allanschwartz/ClockWall/_Hardware/EliArbel-clockwall/415910_10150989229823438_1177839544_o.jpg

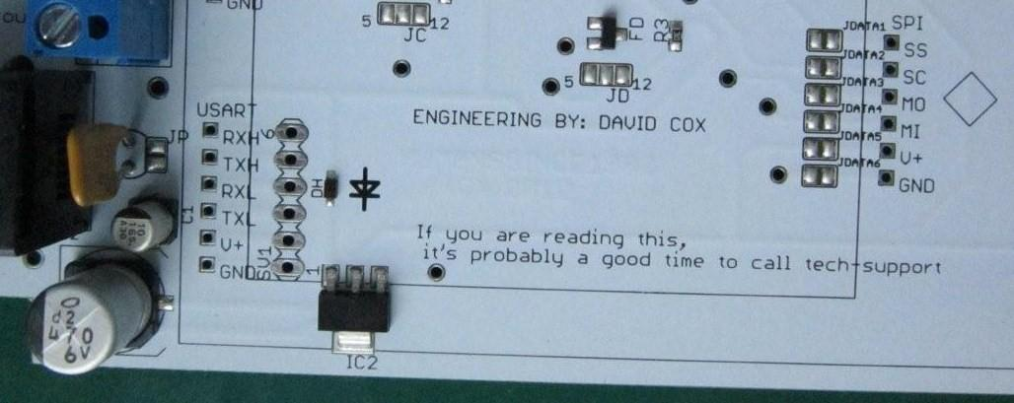
_Hardware/EliArbel-clockwall/415910_10150989229823438_1177839544_o.jpg
