allanschwartz/ClockWall/_Documentation/Connecting Arduinos paper/photos for paper/breadboard2.jpg

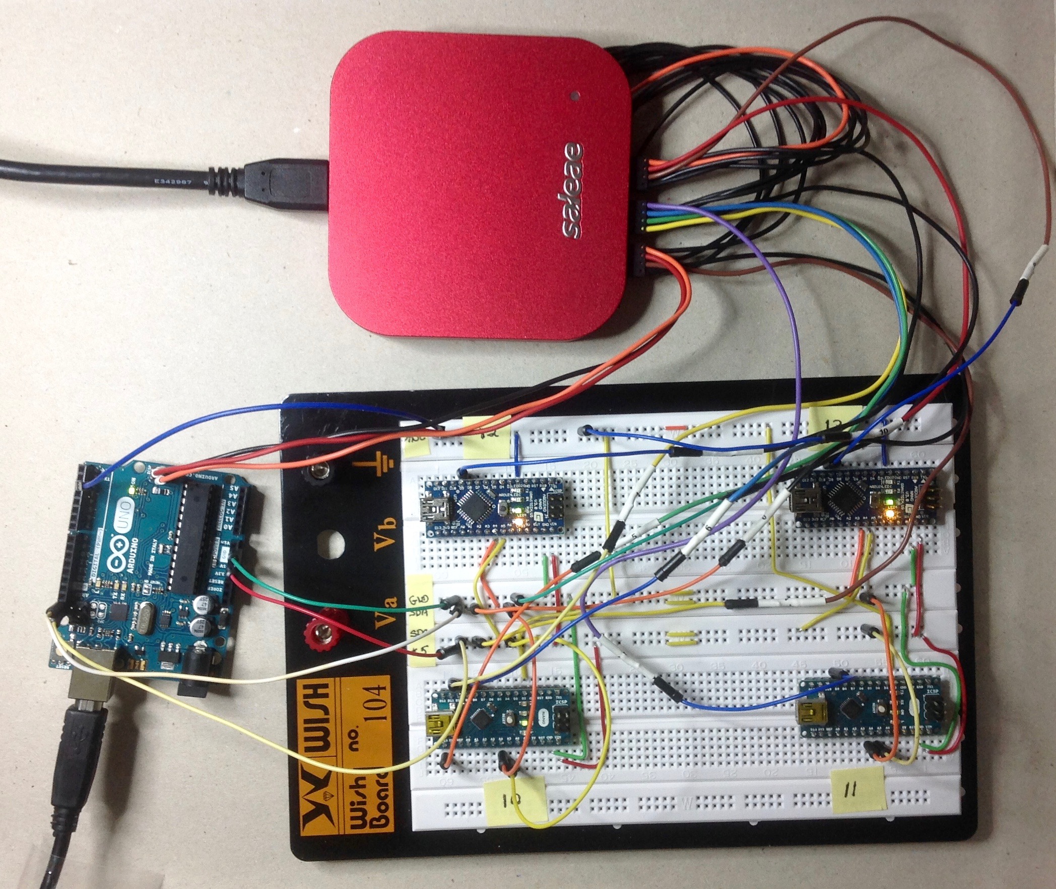
_Documentation/Connecting Arduinos paper/photos for paper/breadboard2.jpg
