allanschwartz/ClockWall/_Documentation/clockwall-arch.pptx

## Slide 2

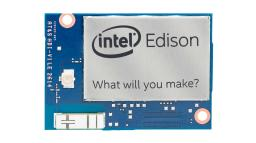
[picture p24: figure]
