allanschwartz/ClockWall/_Documentation/Connecting Arduinos paper/photos for paper/a-million-times_3-620x320.jpg

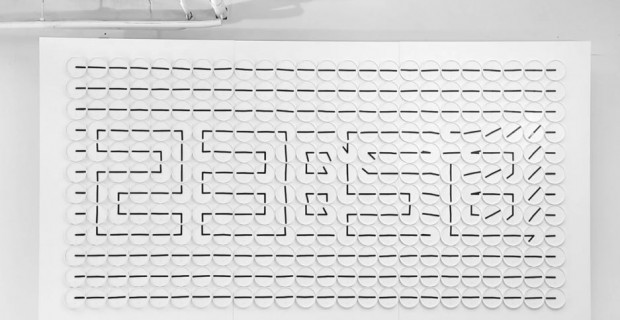
_Documentation/Connecting Arduinos paper/photos for paper/a-million-times_3-620x320.jpg
