allanschwartz/ClockWall/_Documentation/Connecting Arduinos paper/screenshots, connecting arduinos/exper all, 20s,.png

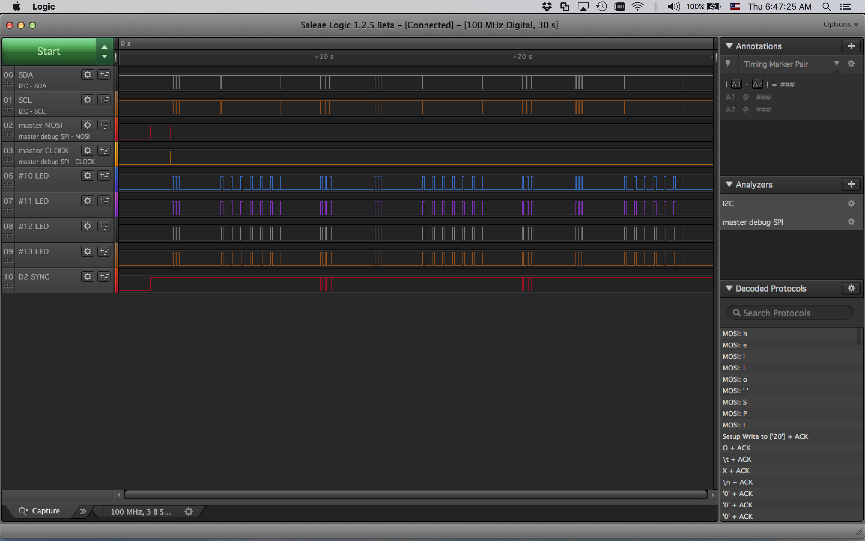
_Documentation/Connecting Arduinos paper/screenshots, connecting arduinos/exper all, 20s,.png
