allanschwartz/ClockWall/_Hardware/_VID28 Motor/Glorification-original-vid28-05-instrument-motor-jac-yuet-with-micro-stepper-motor.jpg

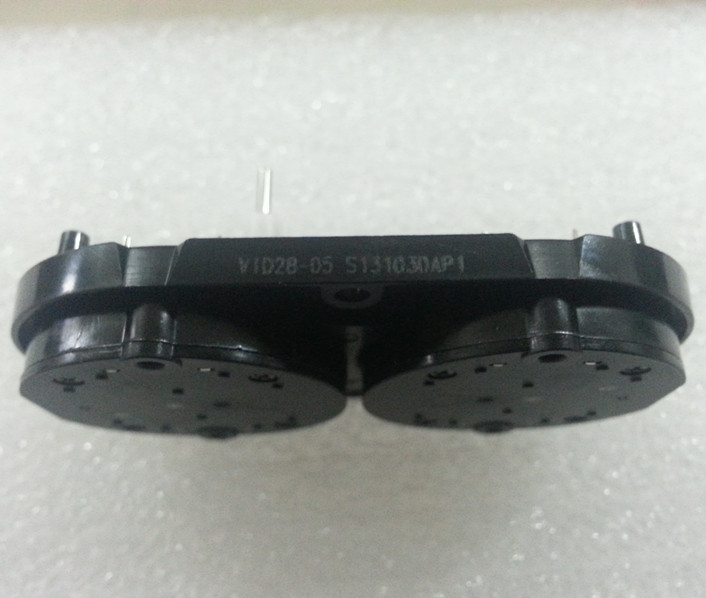
_Hardware/_VID28 Motor/Glorification-original-vid28-05-instrument-motor-jac-yuet-with-micro-stepper-motor.jpg
