allanschwartz/ClockWall/_Hardware/abandoned 4_clock_module/4_clocks, Mar 24, 2017.jpeg

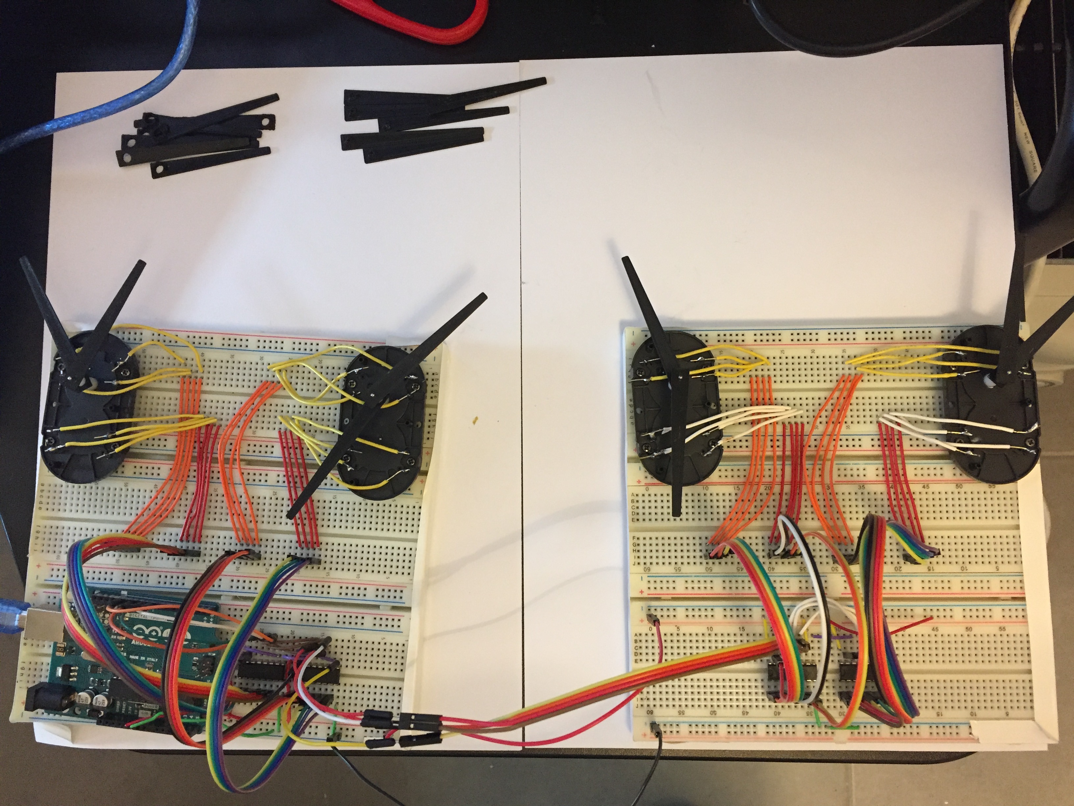
_Hardware/abandoned 4_clock_module/4_clocks, Mar 24, 2017.jpeg
