allanschwartz/ClockWall/_Hardware/bezels and clock-hands detail.png

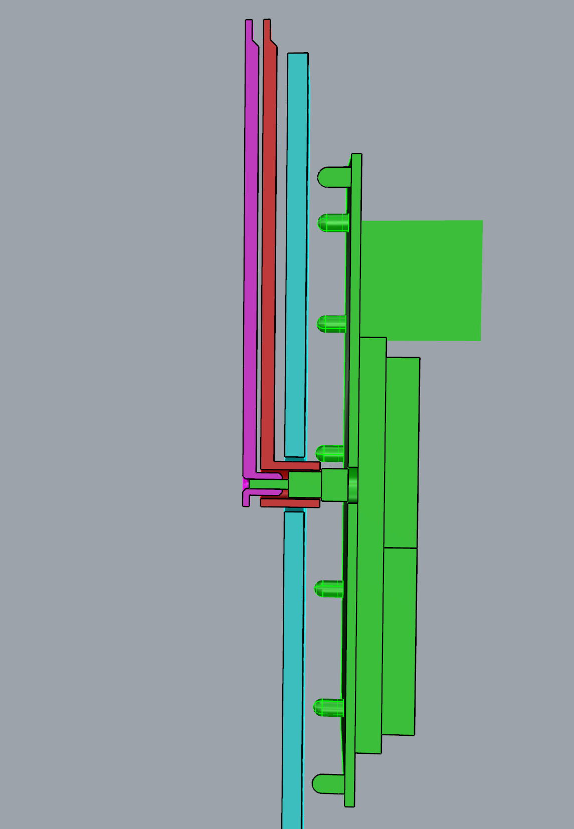
_Hardware/bezels and clock-hands detail.png
