allanschwartz/ClockWall/_Hardware/cables/clock module cable, 2.54mm, 2017-10-07.png

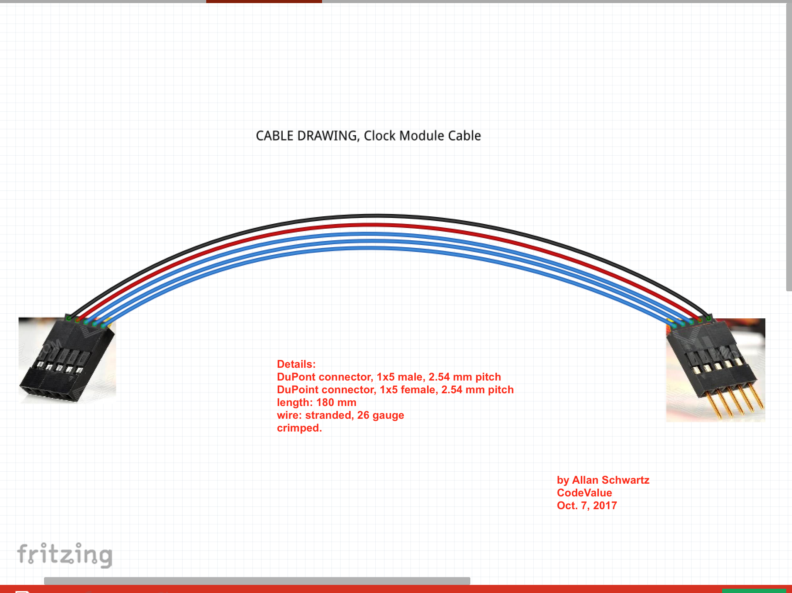
_Hardware/cables/clock module cable, 2.54mm, 2017-10-07.png
