allanschwartz/ClockWall/_Hardware/cables/Screen Shot 2017-12-07 at 11.31.00 AM.png

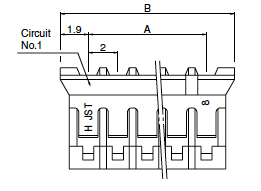
_Hardware/cables/Screen Shot 2017-12-07 at 11.31.00 AM.png
