allanschwartz/ClockWall/_Hardware/Driver-options/FE0HJ4IHD2RLNN4.LARGE.jpg

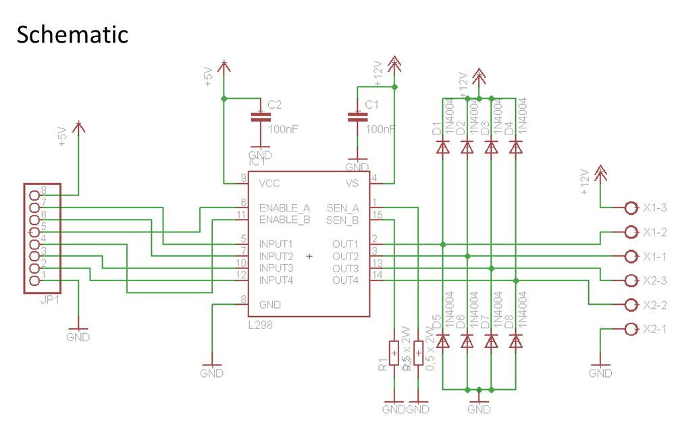
_Hardware/Driver-options/FE0HJ4IHD2RLNN4.LARGE.jpg
