allanschwartz/ClockWall/_Hardware/EliArbel-clockwall/1505503_10152708555028438_704475474_n.jpg

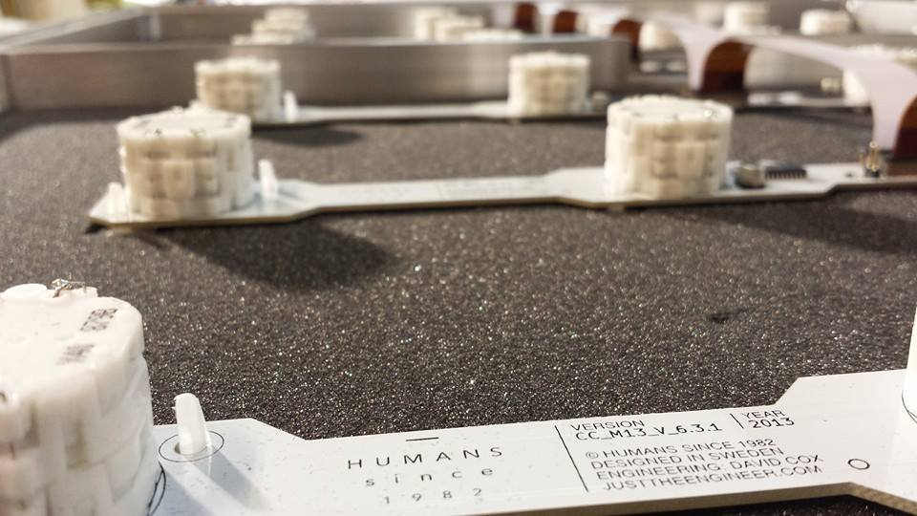
_Hardware/EliArbel-clockwall/1505503_10152708555028438_704475474_n.jpg
