allanschwartz/ClockWall/_Hardware/EliArbel-clockwall/amt96-1280x1280px9.jpg

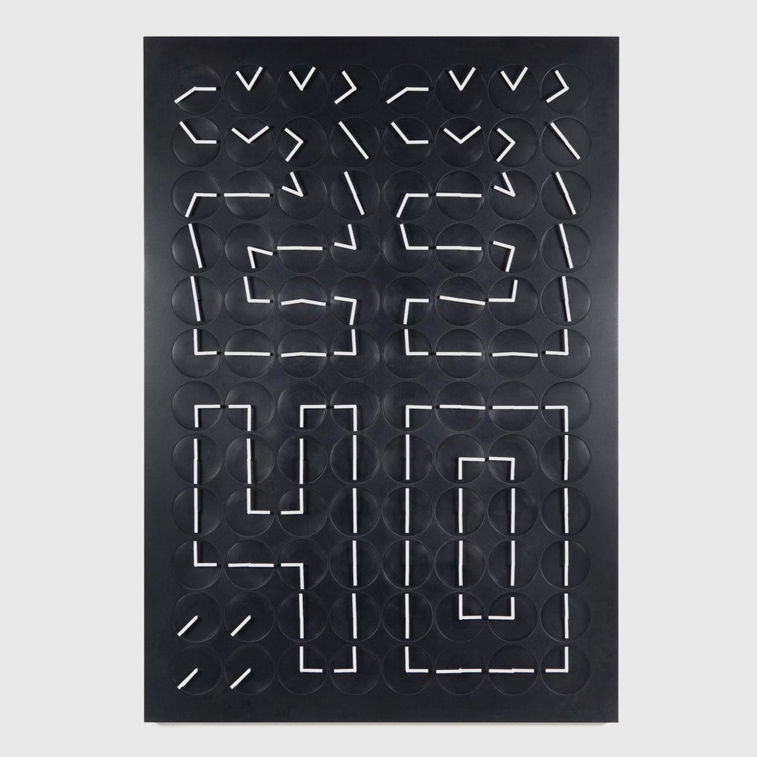
_Hardware/EliArbel-clockwall/amt96-1280x1280px9.jpg
