allanschwartz/ClockWall/_Hardware/EliArbel-clockwall/amt288-1280x1280px1.jpg

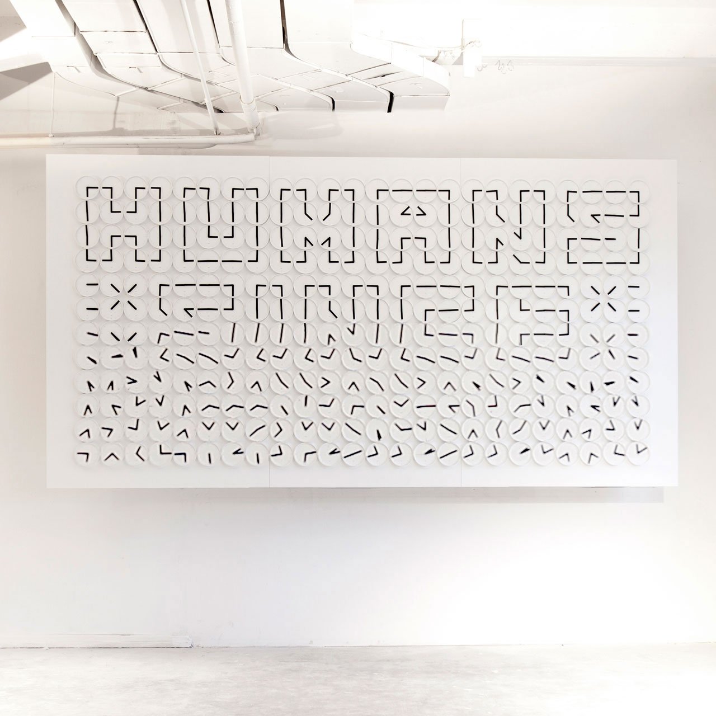
_Hardware/EliArbel-clockwall/amt288-1280x1280px1.jpg
