allanschwartz/ClockWall/_Hardware/EliArbel-clockwall/detail1.jpg

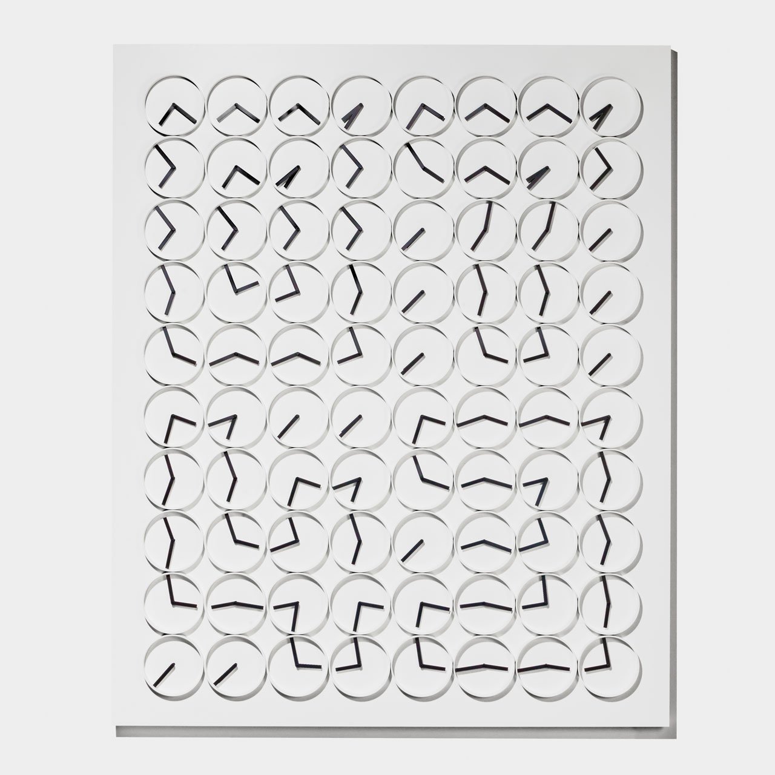
_Hardware/EliArbel-clockwall/detail1.jpg
