allanschwartz/ClockWall/_Hardware/EliArbel-clockwall/detail-1.jpg

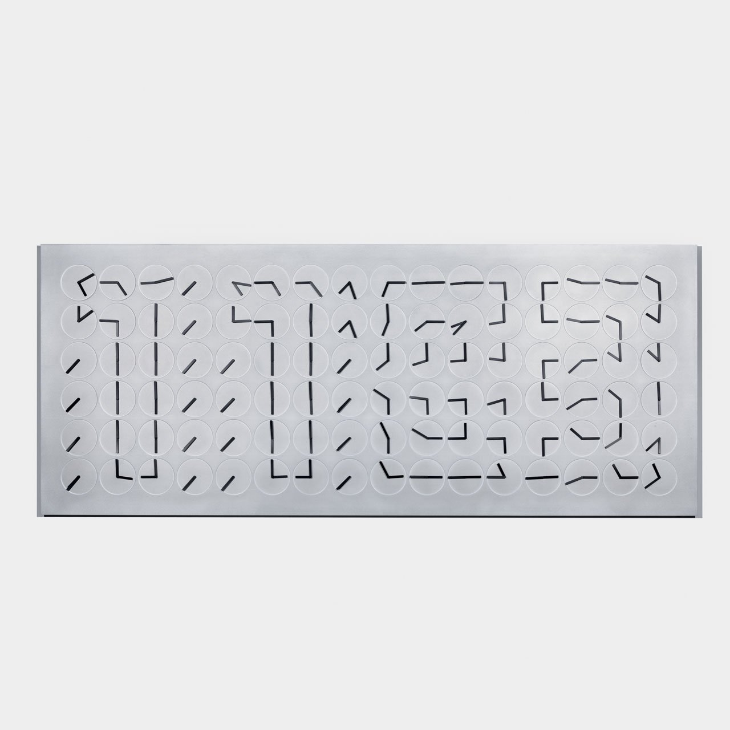
_Hardware/EliArbel-clockwall/detail-1.jpg
