allanschwartz/ClockWall/_Hardware/EliArbel-clockwall/hs1982-amt24-anodized-a-1280x1280px.jpg

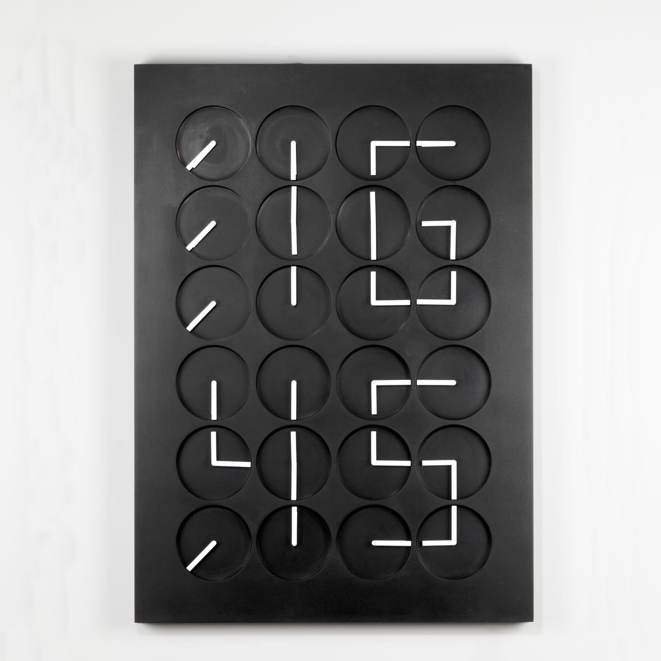
_Hardware/EliArbel-clockwall/hs1982-amt24-anodized-a-1280x1280px.jpg
