allanschwartz/ClockWall/_Hardware/EliArbel-clockwall/hs1982-amt84v-anodized-a-1280x1280px_0.jpg

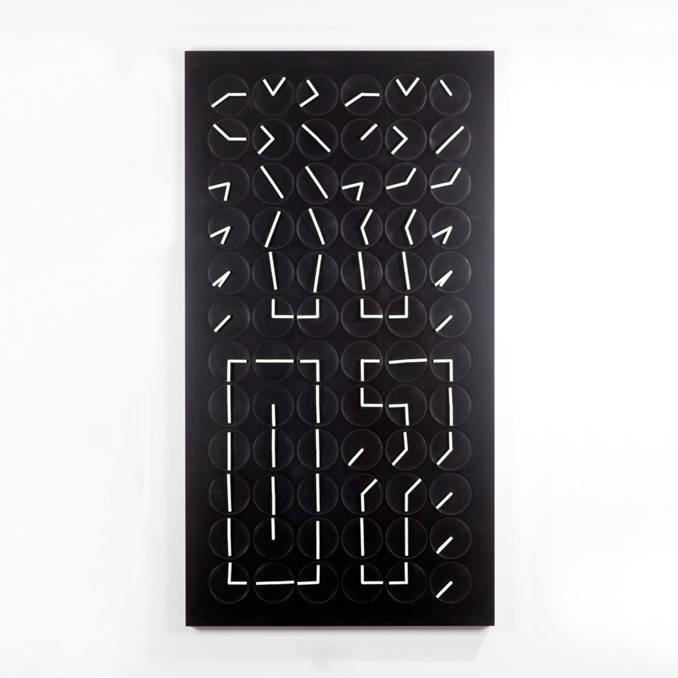
_Hardware/EliArbel-clockwall/hs1982-amt84v-anodized-a-1280x1280px_0.jpg
