allanschwartz/ClockWall/_Hardware/LDR work/IMG_3464.jpg

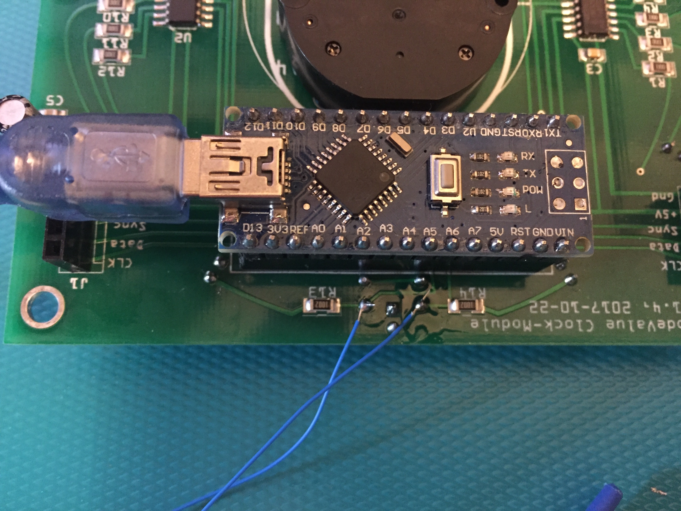
_Hardware/LDR work/IMG_3464.jpg
