allanschwartz/ClockWall/_Hardware/LDR work/IMG_3467.jpg

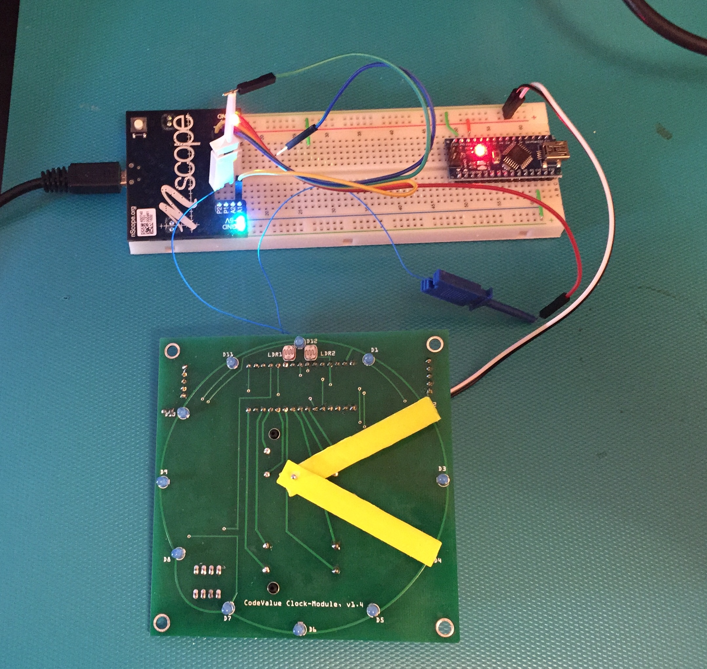
_Hardware/LDR work/IMG_3467.jpg
