allanschwartz/ClockWall/_Hardware/LDR work/LDR capture 1.png

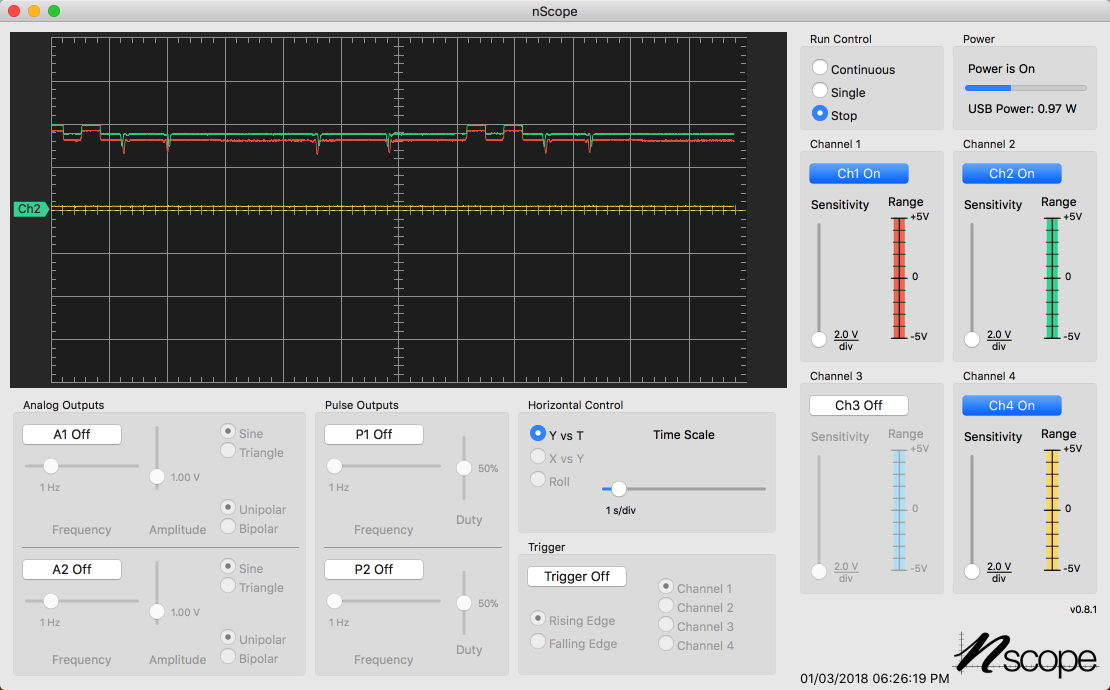
_Hardware/LDR work/LDR capture 1.png
