allanschwartz/ClockWall/_Hardware/neopixel ring 12.png

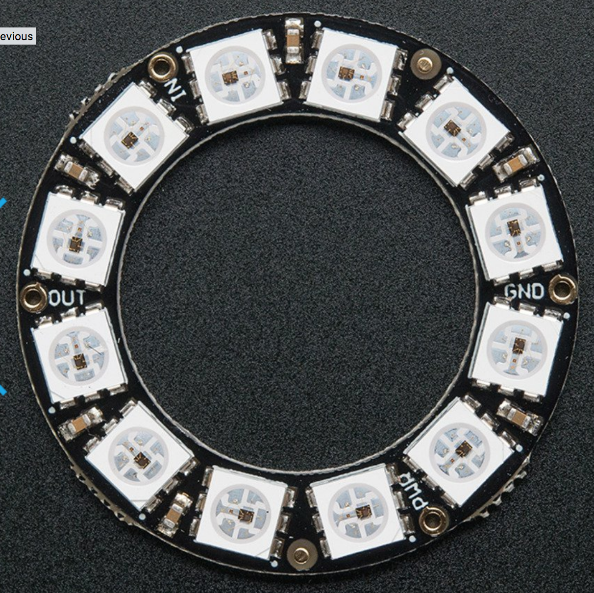
_Hardware/neopixel ring 12.png
