allanschwartz/ClockWall/_Hardware/neopixel ring 2851-01.jpg

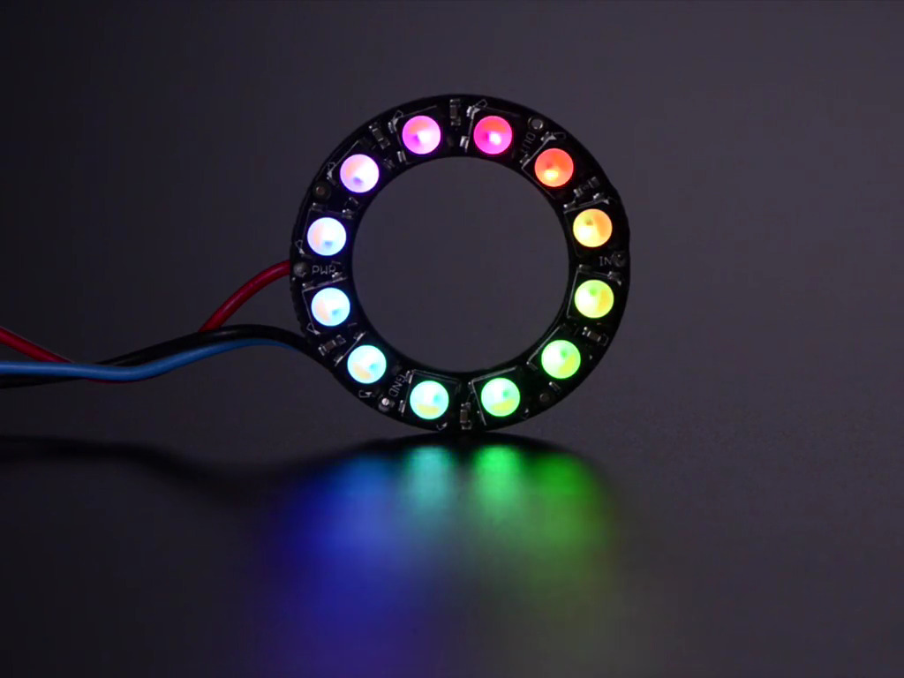
_Hardware/neopixel ring 2851-01.jpg
