allanschwartz/ClockWall/_Hardware/rys.dswic2.jpg

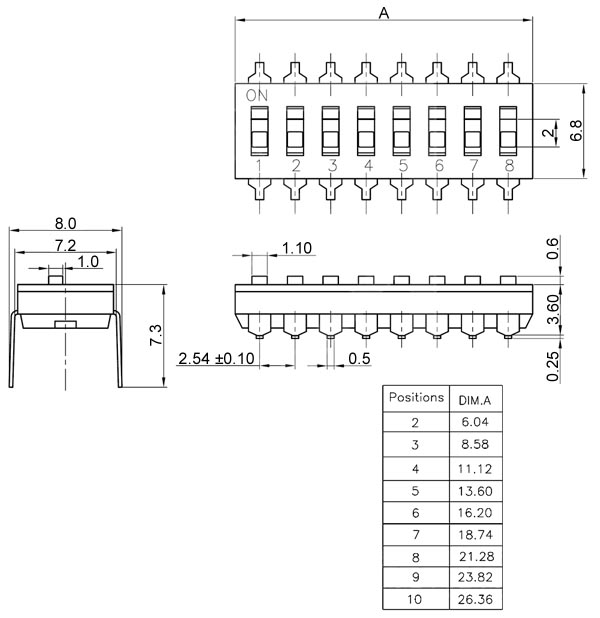
_Hardware/rys.dswic2.jpg
