allanschwartz/ClockWall/ClockModule Controller/v1.4c/clock_module_v1.4c_bb.png

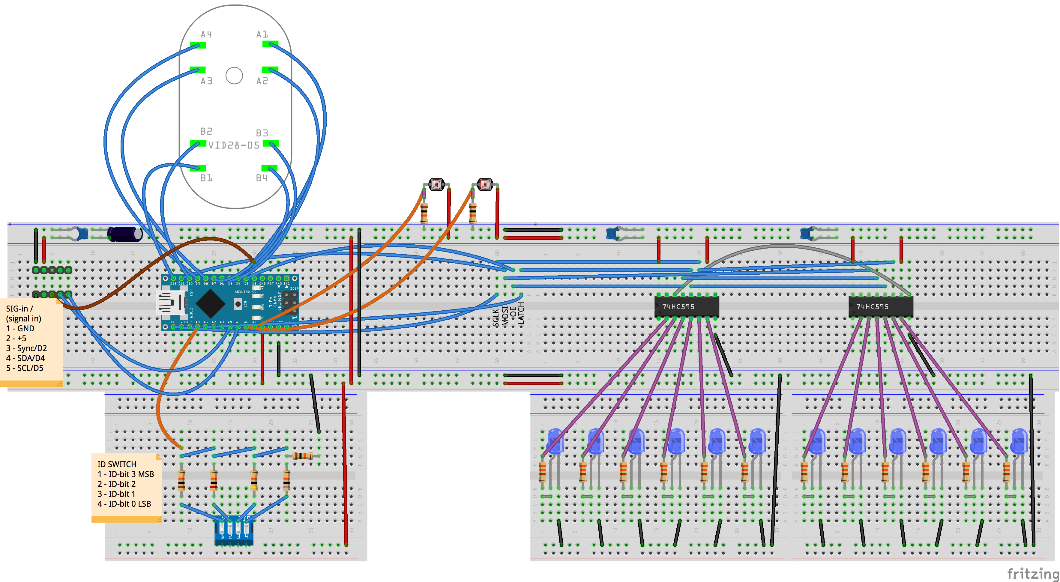
ClockModule Controller/v1.4c/clock_module_v1.4c_bb.png
