allanschwartz/ClockWall/ClockModule Controller/v1.4c/clock_module_v1.4c_schem.png

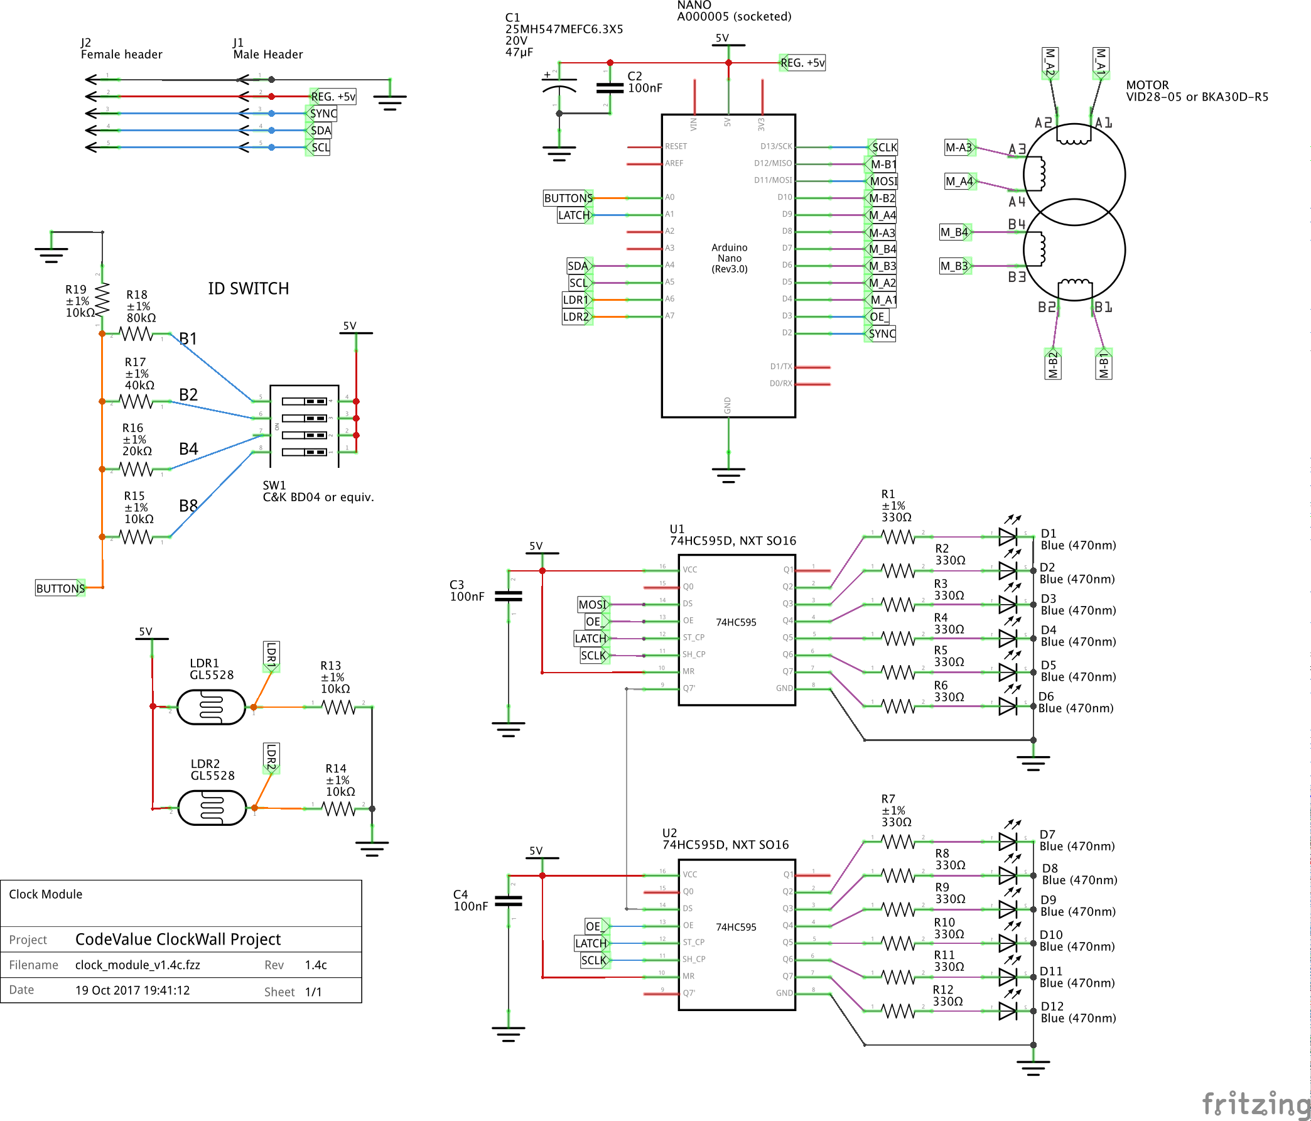
ClockModule Controller/v1.4c/clock_module_v1.4c_schem.png
