allanschwartz/ClockWall/ClockModule Controller/v1.4d/clock_module_v1.4d no LEDs_pcb.png

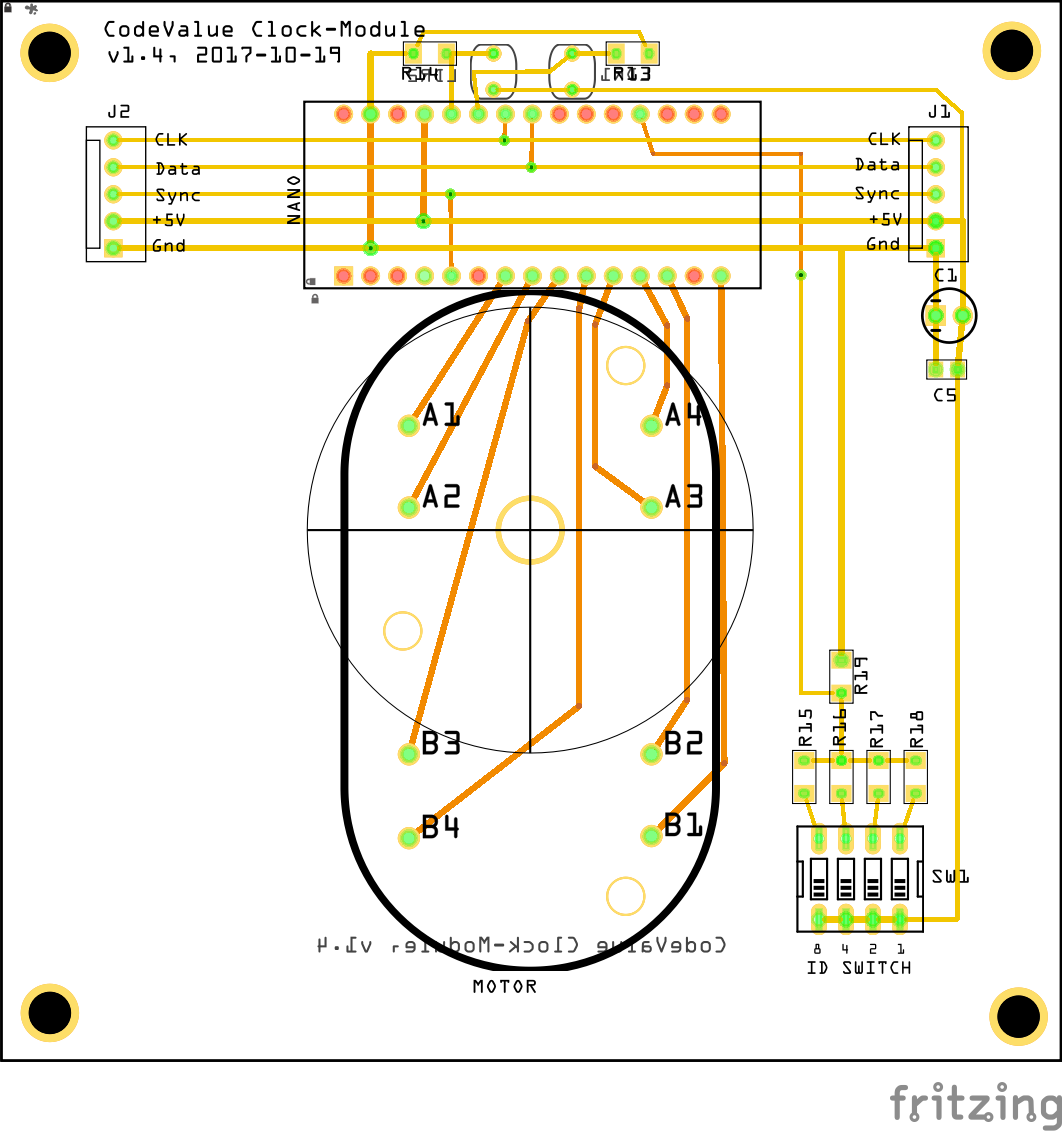
ClockModule Controller/v1.4d/clock_module_v1.4d no LEDs_pcb.png
