allanschwartz/ClockWall/ClockModule Controller/v1.4d/clock_module_v1.4d_pcb_bottom.png

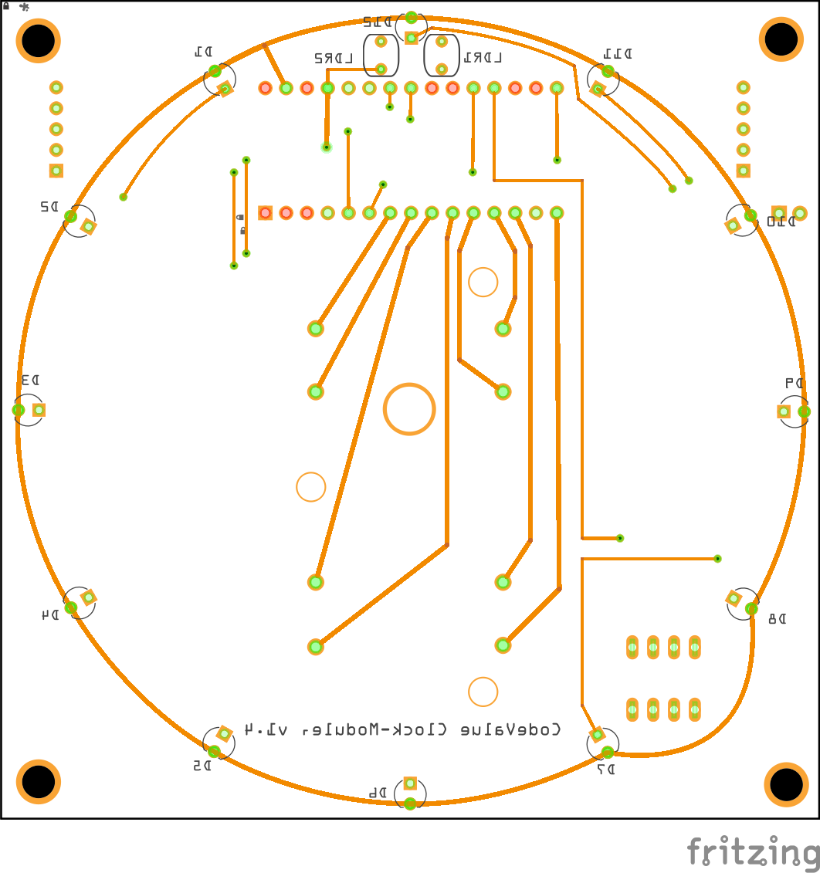
ClockModule Controller/v1.4d/clock_module_v1.4d_pcb_bottom.png
