allanschwartz/ClockWall/ClockModule Controller/v1.5/clock_module_v1.5_schem.png

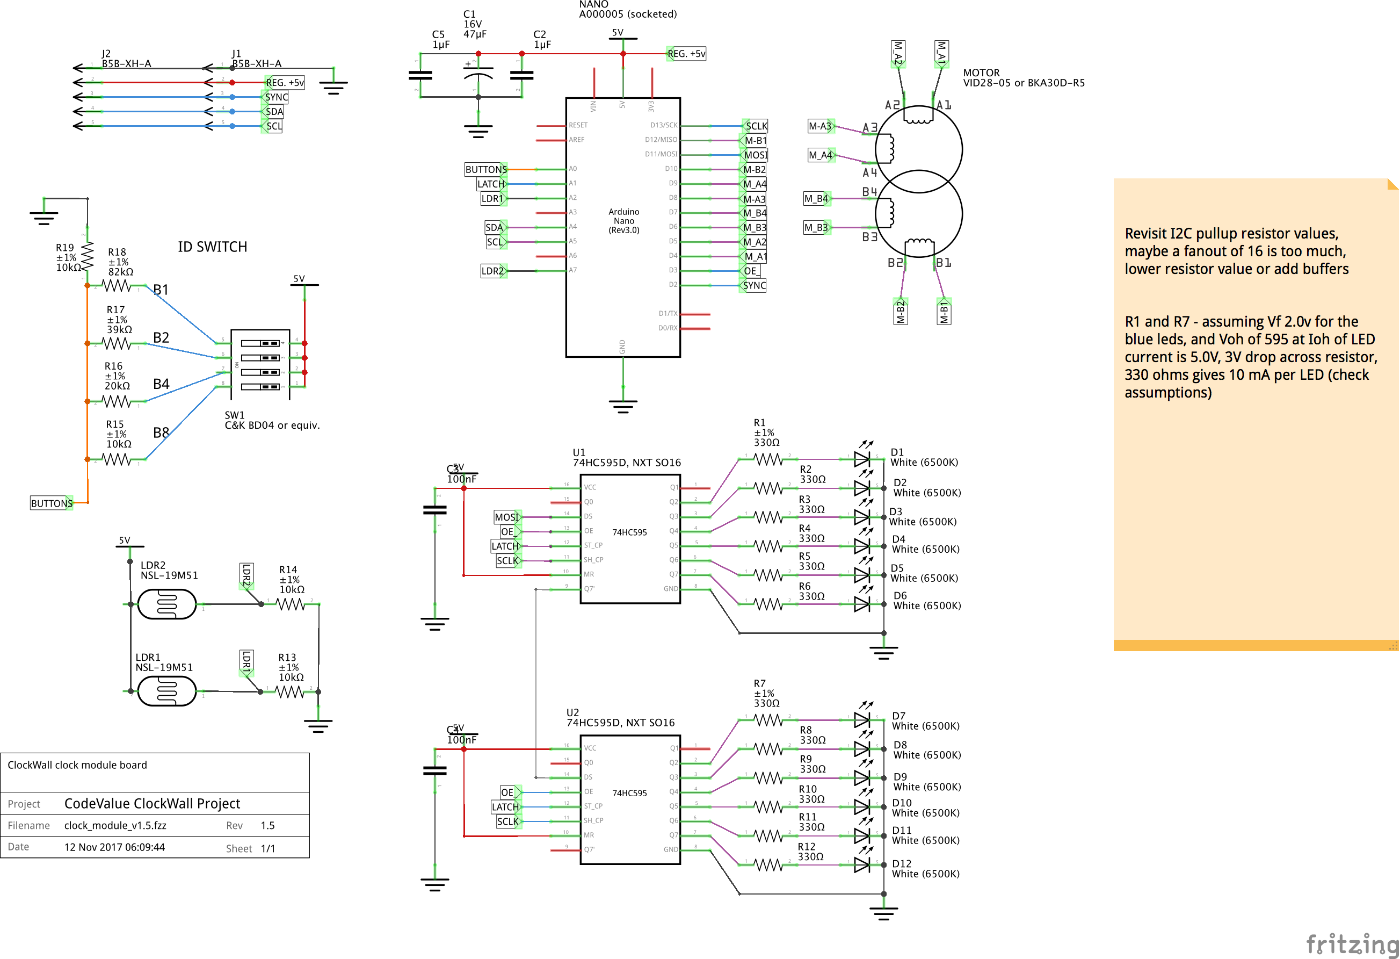
ClockModule Controller/v1.5/clock_module_v1.5_schem.png
