allanschwartz/ClockWall/ClockModule Controller/v1.5/ClockModule 1.5 or W07135ASD21.jpg

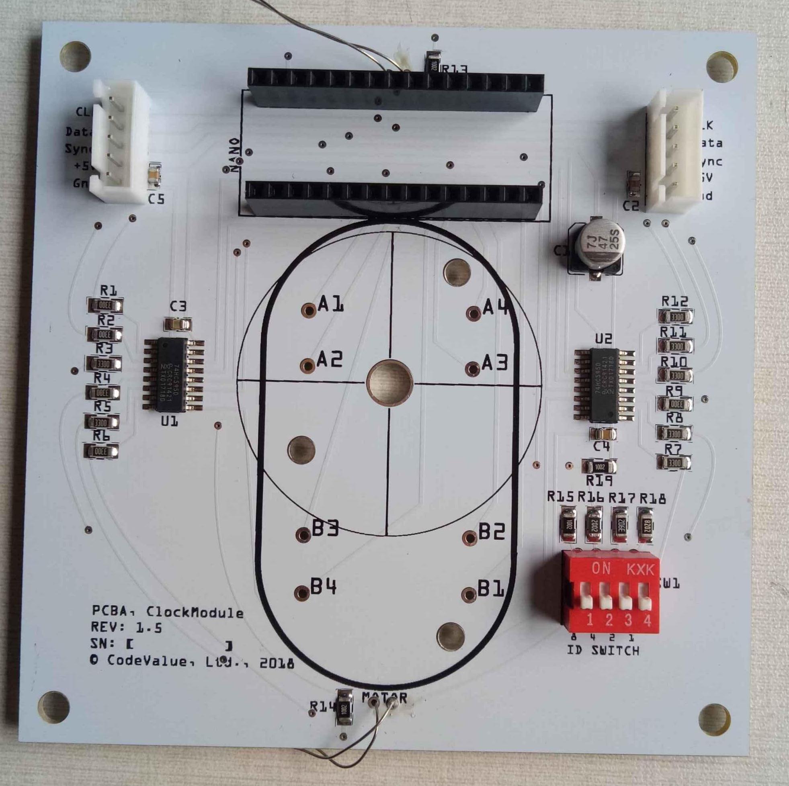
ClockModule Controller/v1.5/ClockModule 1.5 or W07135ASD21.jpg
