allanschwartz/ClockWall/Cluster Controller/cluster_controller_v1.1_pcb.jpg

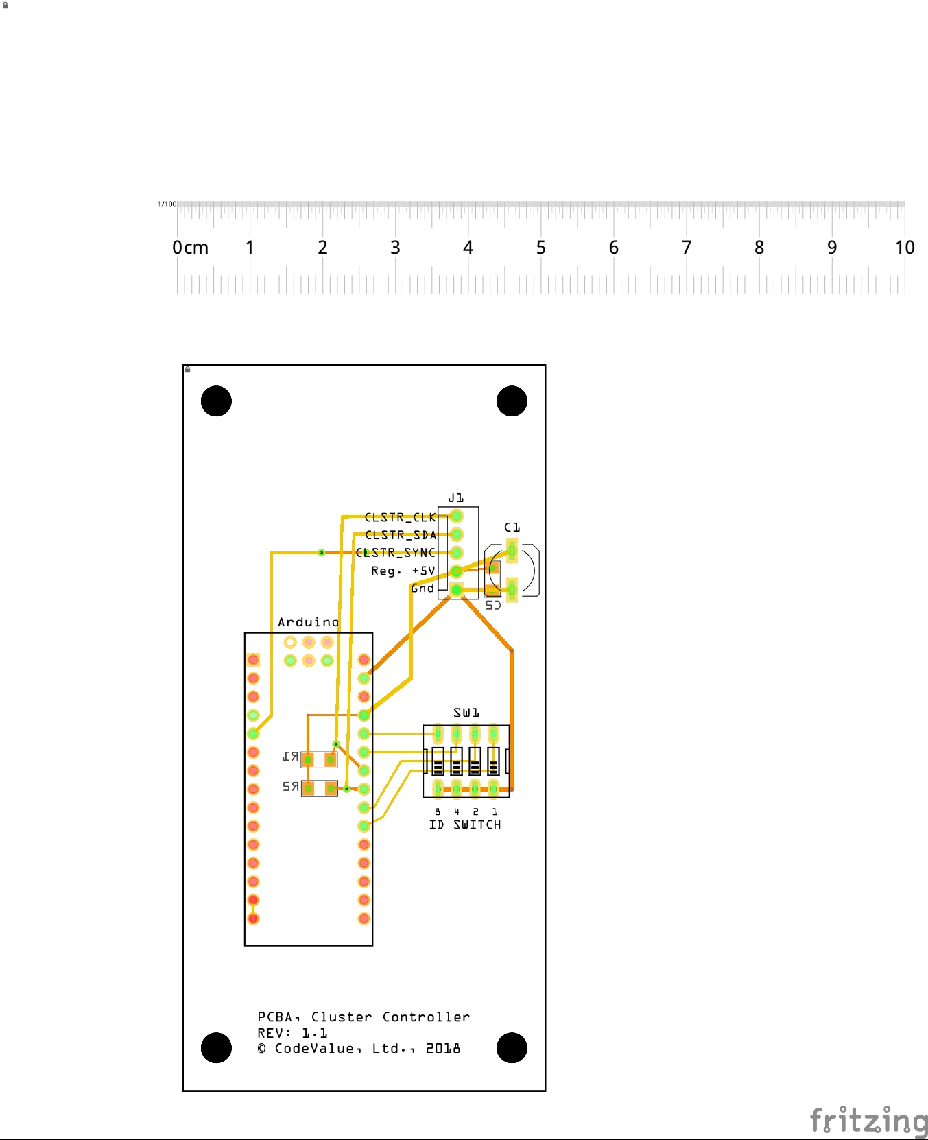
Cluster Controller/cluster_controller_v1.1_pcb.jpg
