allanschwartz/ClockWall/Cluster Controller/cluster_controller_v1.1_schem.jpg

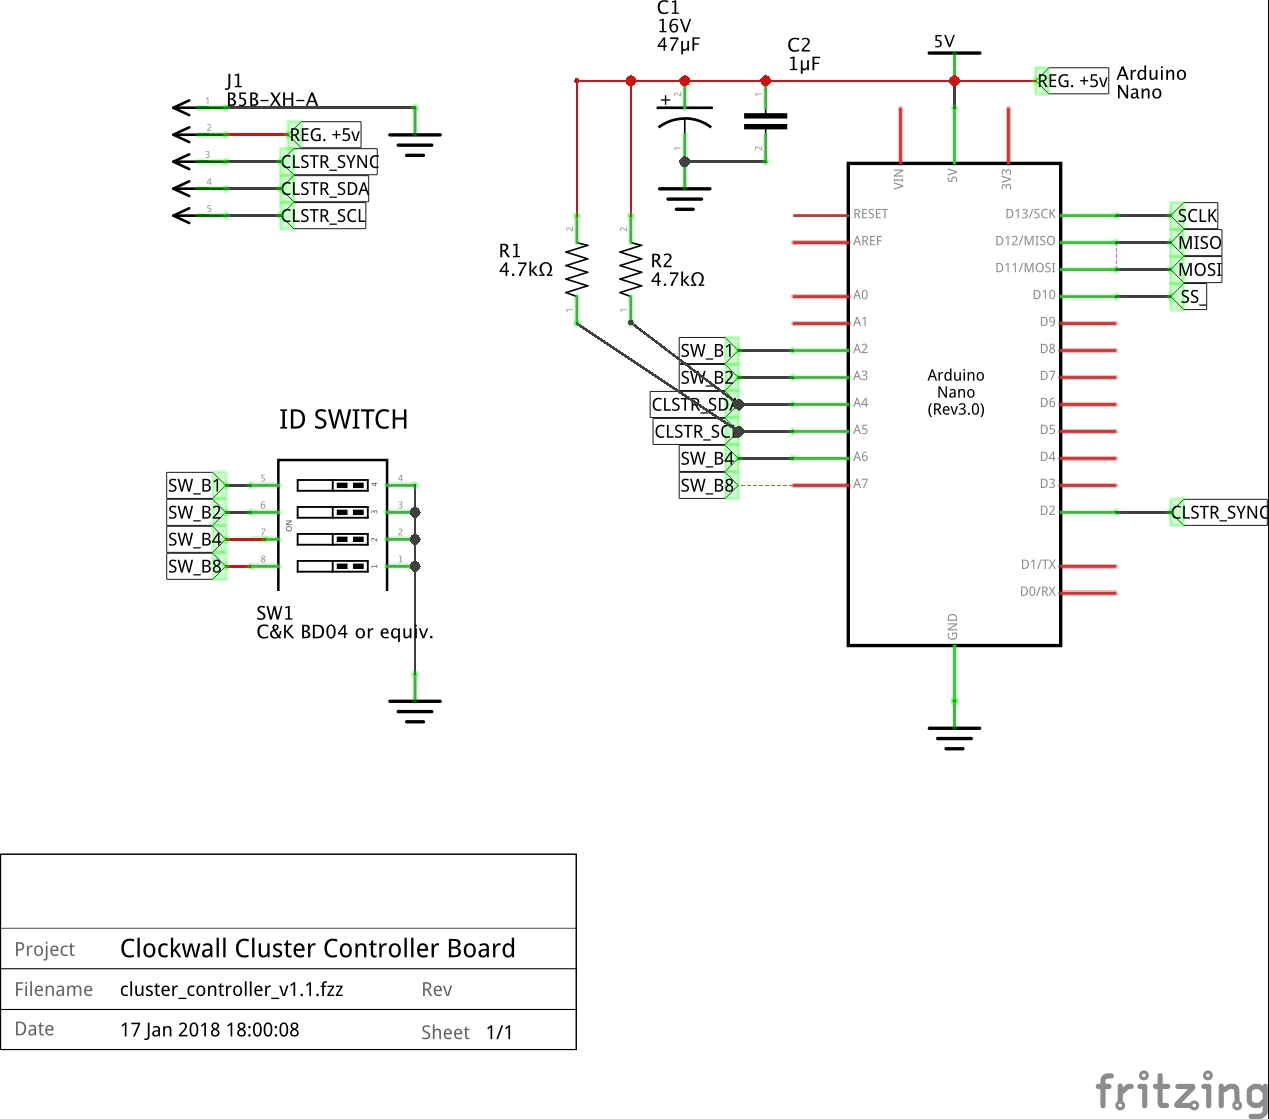
Cluster Controller/cluster_controller_v1.1_schem.jpg
