allanschwartz/ClockWall/Cluster Controller/Power,Signal Dist 1.1 first.JPG

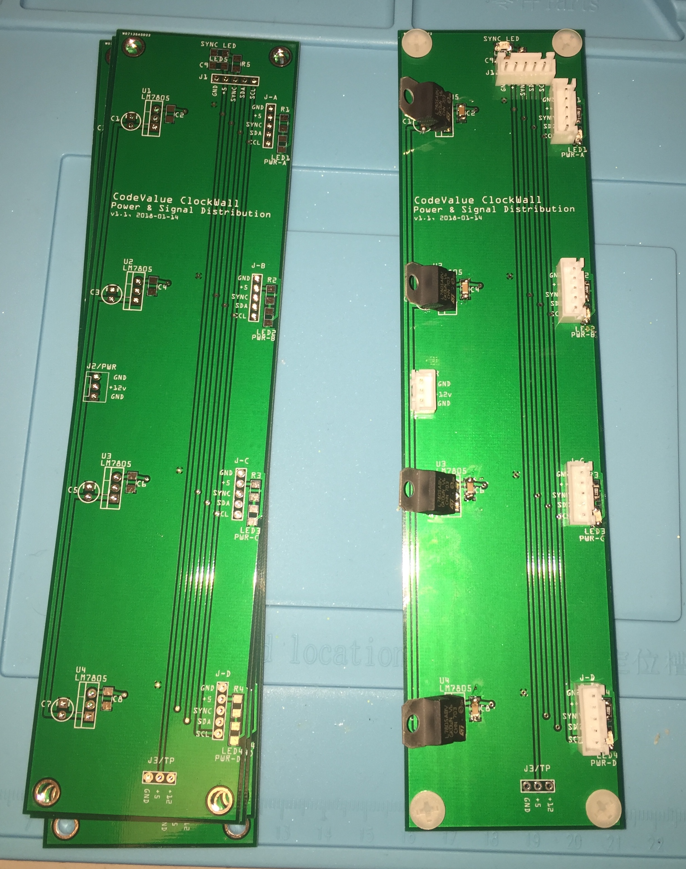
Cluster Controller/Power,Signal Dist 1.1 first.JPG
