allanschwartz/ClockWall/ClockModule Controller/v1.4d/clock_module_v1.4d_bom.html

Label | Part Type | Properties
C1 | Electrolytic Capacitor | package 100 mil [THT, electrolytic]; capacitance 47µF; voltage 20V; part # 25MH547MEFC6.3X5
C2 | Ceramic Capacitor | package 0805 [SMD, multilayer]; capacitance 100nF; voltage 6.3V
C3 | Ceramic Capacitor | package 0805 [SMD, multilayer]; capacitance 100nF; voltage 6.3V
C4 | Ceramic Capacitor | package 0805 [SMD, multilayer]; capacitance 100nF; voltage 6.3V
D1 | Blue (470nm) LED | package 3 mm [THT]; color Blue (470nm); leg yes
D2 | Blue (470nm) LED | package 3 mm [THT]; color Blue (470nm); leg yes
D3 | Blue (470nm) LED | package 3 mm [THT]; color Blue (470nm); leg yes
D4 | Blue (470nm) LED | package 3 mm [THT]; color Blue (470nm); leg yes
D5 | Blue (470nm) LED | package 3 mm [THT]; color Blue (470nm); leg yes
D6 | Blue (470nm) LED | package 3 mm [THT]; color Blue (470nm); leg yes
D7 | Blue (470nm) LED | package 3 mm [THT]; color Blue (470nm); leg yes
D8 | Blue (470nm) LED | package 3 mm [THT]; color Blue (470nm); leg yes
D9 | Blue (470nm) LED | package 3 mm [THT]; color Blue (470nm); leg yes
D10 | Blue (470nm) LED | package 3 mm [THT]; color Blue (470nm); leg yes
D11 | Blue (470nm) LED | package 3 mm [THT]; color Blue (470nm); leg yes
D12 | Blue (470nm) LED | package 3 mm [THT]; color Blue (470nm); leg yes
J1 | Generic molex header - 5 pins | package THT; hole size 0.7mm,0.508mm; pins 5; form molex; row single; pin spacing 0.1in (2.54mm); part # Male Header
J2 | Generic molex header - 5 pins | package THT; hole size 0.7mm,0.508mm; pins 5; form molex; row single; pin spacing 0.1in (2.54mm); part # Female header
LDR1 | Photocell (LDR) | resistance@ luminance 16 kOhms@ 10 lux; package THT; resistance@ dark 300 kOhms@ 10 seconds; variant variant 1; part # GL5528
LDR2 | Photocell (LDR) | resistance@ luminance 16 kOhms@ 10 lux; package THT; resistance@ dark 300 kOhms@ 10 seconds; variant variant 1; part # GL5528
MOTOR | Motor- VID28 | package motor-64mm; variant 64mm; part # VID28-05 or BKA30D-R5
NANO | Arduino Nano (Rev3.0) | type Arduino Nano (3.0); part # A000005 (socketed)
Part1 | Schematic Frame | rev 1.4c; date 1508467272; descr Clock Module; sheet 1/1; project CodeValue ClockWall Project; filename clock_module_v1.4c.fzz
R1 | 330Ω Resistor | package 1206 [SMD]; tolerance ±1%; resistance 330Ω
R2 | 330Ω Resistor | package 1206 [SMD]; tolerance ±1%; resistance 330Ω
R3 | 330Ω Resistor | package 1206 [SMD]; tolerance ±1%; resistance 330Ω
R4 | 330Ω Resistor | package 1206 [SMD]; tolerance ±1%; resistance 330Ω
R5 | 330Ω Resistor | package 1206 [SMD]; tolerance ±1%; resistance 330Ω
R6 | 330Ω Resistor | package 1206 [SMD]; tolerance ±1%; resistance 330Ω
R7 | 330Ω Resistor | package 1206 [SMD]; tolerance ±1%; resistance 330Ω
R8 | 330Ω Resistor | package 1206 [SMD]; tolerance ±1%; resistance 330Ω
R9 | 330Ω Resistor | package 1206 [SMD]; tolerance ±1%; resistance 330Ω
R10 | 330Ω Resistor | package 1206 [SMD]; tolerance ±1%; resistance 330Ω
R11 | 330Ω Resistor | package 1206 [SMD]; tolerance ±1%; resistance 330Ω
R12 | 330Ω Resistor | package 1206 [SMD]; tolerance ±1%; resistance 330Ω
R13 | 10kΩ Resistor | package 1206 [SMD]; tolerance ±1%; resistance 10kΩ
R14 | 10kΩ Resistor | package 1206 [SMD]; tolerance ±1%; resistance 10kΩ
R15 | 10kΩ Resistor | package 1206 [SMD]; tolerance ±1%; resistance 10kΩ
R16 | 20kΩ Resistor | package 1206 [SMD]; tolerance ±1%; resistance 20kΩ
R17 | 40kΩ Resistor | package 1206 [SMD]; tolerance ±1%; resistance 40kΩ
R18 | 80kΩ Resistor | package 1206 [SMD]; tolerance ±1%; resistance 80kΩ
R19 | 10kΩ Resistor | package 1206 [SMD]; tolerance ±1%; resistance 10kΩ
SW1 | DIP Switch 4 Position | package dipswitch-04; channels 4; variant variant 2; part # C&K BD04 or equiv.
U1 | 74HC595 SMD | package SO16 [SMD]; logic family 74xx; part # 74HC595D, NXT SO16
U2 | 74HC595 SMD | package SO16 [SMD]; logic family 74xx; part # 74HC595D, NXT SO16
Amount | Part Type | Properties
1 | Electrolytic Capacitor | package 100 mil [THT, electrolytic]; capacitance 47µF; voltage 20V; part # 25MH547MEFC6.3X5
3 | Ceramic Capacitor | package 0805 [SMD, multilayer]; capacitance 100nF; voltage 6.3V
12 | Blue (470nm) LED | package 3 mm [THT]; color Blue (470nm); leg yes
1 | Generic molex header - 5 pins | package THT; hole size 0.7mm,0.508mm; pins 5; form molex; row single; pin spacing 0.1in (2.54mm); part # Male Header
1 | Generic molex header - 5 pins | package THT; hole size 0.7mm,0.508mm; pins 5; form molex; row single; pin spacing 0.1in (2.54mm); part # Female header
2 | Photocell (LDR) | resistance@ luminance 16 kOhms@ 10 lux; package THT; resistance@ dark 300 kOhms@ 10 seconds; variant variant 1; part # GL5528
1 | Motor- VID28 | package motor-64mm; variant 64mm; part # VID28-05 or BKA30D-R5
1 | Arduino Nano (Rev3.0) | type Arduino Nano (3.0); part # A000005 (socketed)
1 | Schematic Frame | rev 1.4c; date 1508467272; descr Clock Module; sheet 1/1; project CodeValue ClockWall Project; filename clock_module_v1.4c.fzz
12 | 330Ω Resistor | package 1206 [SMD]; tolerance ±1%; resistance 330Ω
4 | 10kΩ Resistor | package 1206 [SMD]; tolerance ±1%; resistance 10kΩ
1 | 20kΩ Resistor | package 1206 [SMD]; tolerance ±1%; resistance 20kΩ
1 | 40kΩ Resistor | package 1206 [SMD]; tolerance ±1%; resistance 40kΩ
1 | 80kΩ Resistor | package 1206 [SMD]; tolerance ±1%; resistance 80kΩ
1 | DIP Switch 4 Position | package dipswitch-04; channels 4; variant variant 2; part # C&K BD04 or equiv.
2 | 74HC595 SMD | package SO16 [SMD]; logic family 74xx; part # 74HC595D, NXT SO16
