allanschwartz/ClockWall/ClockModule Controller/v1.5/clock module BOM v1.5.xlsx

 |  |  |  |  |  |  | Bill of Materials: clock_module_v1.5.fzz
 |  |  |  |  |  |  | /Users/allan/Desktop/ClockWall/ClockWall/Clock Module PCB/v1.4d/clock_module_v1.4d.fzz
 |  |  |  |  |  |  | Thursday, December 21, 2017
 |  |  |  |  |  |  | Shopping List
digi-key | digi-key | PCBWAY | PCBWAY |  |  | *suggested* | Amount | Part Type | Properties | Provider
part price | Total | part price | Total | note | LABEL | MPN | SMD Parts for PCBWAY to provide and install |  |  |  | digi-key PN
$0.041 | $0.082 | $0.032 | $0.065 | or equiv. | C2, C5 | C0805C104K4RACTU (https://www.digikey.com/product-detail/en/kemet/C0805C104K4RACTU/399-1167-1-ND/411442) | 2 | Ceramic Capacitor, 0805 | CAP CER 1uF 16v X7R; package 0805 [SMD] | KEMET | 399-1167-1-ND (https://www.digikey.com/product-detail/en/kemet/C0805C104K4RACTU/399-1167-1-ND/411442)
$0.041 | $0.082 | $0.032 | $0.065 | or equiv. | C3, C4 | C0805C105K4RACTU (https://www.digikey.com/product-detail/en/kemet/C0805C105K4RACTU/399-1284-1-ND/416060) | 2 | Ceramic Capacitor, 0805 | CAP CER 0.1uF 16v X7R; package 0805 [SMD] | KEMET | 399-1284-1-ND (https://www.digikey.com/product-detail/en/kemet/C0805C105K4RACTU/399-1284-1-ND/416060)
$0.014 | $0.163 | $0.032 | $0.389 |  | R1,R2,R3,R4,R5,R6 R7,R8,R9,R10,R11,R12 | RC1206FR-07330RL (https://www.digikey.com/product-detail/en/yageo/RC1206FR-07330RL/311-330FRCT-ND/731769) | 12 | 330Ω Resistor, 1206 | Resistor 330Ω; tolerance ±1%; package 1206 [SMD] | YAGEO | 311-330FRDKR-ND (https://www.digikey.com/product-detail/en/yageo/RC1206FR-07330RL/311-330FRDKR-ND/734716)
$0.033 | $0.132 | $0.032 | $0.130 |  | R13,R14,R15,R19 | RC1206FR-0710KL (https://www.digikey.com/product-detail/en/yageo/RC1206FR-0710KL/311-10.0KFRCT-ND/731430) | 4 | 10kΩ Resistor, 1206 | Resistor 10kΩ; tolerance ±1%; package 1206 [SMD] | YAGEO | 311-10.0KFRCT-ND (https://www.digikey.com/product-detail/en/yageo/RC1206FR-0710KL/311-10.0KFRCT-ND/731430)
$0.033 | $0.033 | $0.032 | $0.032 |  | R16 | RC1206FR-0720KL (https://www.digikey.com/product-detail/en/yageo/RC1206FR-0720KL/311-20.0KFRCT-ND/731619) | 1 | 20kΩ Resistor, 1206 | Resistor 20kΩ; tolerance ±1%; package 1206 [SMD] | YAGEO | 311-20.0KFRCT-ND (https://www.digikey.com/product-detail/en/yageo/RC1206FR-0720KL/311-20.0KFRCT-ND/731619)
$0.033 | $0.033 | $0.032 | $0.032 |  | R17 | RC1206FR-0740K2L (https://www.digikey.com/product-detail/en/yageo/RC1206FR-0740K2L/311-40.2KFRCT-ND/731846) | 1 | 39kΩ Resistor , 1206 | Resistor 39kΩ; tolerance ±1%; package 1206 [SMD] | YAGEO | 311-40.2KFRCT-ND (https://www.digikey.com/product-detail/en/yageo/RC1206FR-0740K2L/311-40.2KFRCT-ND/731846)
$0.033 | $0.033 | $0.032 | $0.032 |  | R18 | RC1206FR-0780K6L (https://www.digikey.com/product-detail/en/yageo/RC1206FR-0780K6L/311-80.6KFRCT-ND/732073) | 1 | 82kΩ Resistor, 1206 | Resistor 82kΩ; tolerance ±1%; package 1206 [SMD] | YAGEO | 311-80.6KFRCT-ND (https://www.digikey.com/product-detail/en/yageo/RC1206FR-0780K6L/311-80.6KFRCT-ND/732073)
$0.540 | $1.080 | $0.162 | $0.324 |  | U1, U2 | SN74HC595D (https://www.digikey.com/product-detail/en/texas-instruments/SN74HC595D/296-8344-5-ND/376752) | 2 | 74HC595D SMD, SOIC | IC 8-bit SHIFT REGISTER 16-SOIC; [SMD] | TI or NXT | 296-8344-5-ND (https://www.digikey.com/product-detail/en/texas-instruments/SN74HC595D/296-8344-5-ND/376752)
$0.190 | $0.190 | $0.108 | $0.108 | made in china | C1 | 865080-342006 (https://www.digikey.com/product-detail/en/wurth-electronics-inc/865080342006/732-8416-1-ND/5728373) | 1 | Electrolytic Capacitor, SMD | 47 uF 16V Alum Elec Cap Radial Can [SMD] 5.3mm dia. | Wurth | 732-8416-1-ND (https://www.digikey.com/product-detail/en/wurth-electronics-inc/865080342006/732-8416-1-ND/5728373)
$0.137 | $1.644 | $0.108 | $1.296 | made in china | D1,D2,D3,D4,D5,D6 D7,D8,D9,D10,D11,D12 | 150080YS75000 (https://www.digikey.com/products/en?mpart=150080YS75000&v=732) | 12 | Yellow LED, 0805 | LED WHITE CLEAR 0805 SMD | Wurth | 732-4987-1-ND (https://www.digikey.com/product-detail/en/wurth-electronics-inc/150080YS75000/732-4987-1-ND/4489925)
 |  |  |  |  |  |  | 38 |  | total SMD parts
 |  |  |  |  |  |  | THT parts for PCBWAY to provide and install
$0.744 | $0.744 | $0.324 | $0.324 | red one | SW1 | 206-4ST (https://www.digikey.com/product-detail/en/cts-electrocomponents/206-4ST/CT2064ST-ND/20774) | 1 | DIP Switch 4-Position, THT | Dip Switch SPST 4 Position [THT] Slide (Standard) | CTS | CT2064ST-ND (https://www.digikey.com/product-detail/en/cts-electrocomponents/206-4ST/CT2064ST-ND/20774)
$0.780 | $1.560 | $1.296 | $2.592 |  | LDR1, LDR2 | NSL-19M51 (https://www.digikey.com/product-detail/en/luna-optoelectronics/NSL-19M51/NSL-19M51-ND/5039794) | 2 | Photocell (LDR), 2.5mm pitch, THT | CDS Cell 550nm | Luna OptoE | NSL-19M51-ND (https://www.digikey.com/product-detail/en/luna-optoelectronics/NSL-19M51/NSL-19M51-ND/5039794)
$1.480 | $2.960 | $0.108 | $0.216 | generic | NANO header |  | 2 | female headers - 1x16 pins, THT | 1x16 female 2.54mm, height 8.5mm (cut to 1x15)
$0.164 | $0.328 | $0.270 | $0.540 | THT shrouded header | J1, J2 | B5B-XH-A(LF)(SN) (https://www.digikey.com/product-detail/en/jst-sales-america-inc/B5B-XH-A-LF-SN/455-2270-ND/1530483) | 2 | Conn Header XH Top 5pos 2.5mm | 5 Positions Header Connector 0.098" (2.50mm) Through Hole Tin, TOP, JST XH series | JST | 455-2270-ND (https://www.digikey.com/product-detail/en/jst-sales-america-inc/B5B-XH-A-LF-SN/455-2270-ND/1530483)
 |  |  |  |  |  |  | 7 |  | total THT parts
1unit |  | 1unit | $6.145
20units |  | 20units | $122.904
VENDOR | PRICE
PCBWAY | $2.300 |  |  | $46 for 20 boards | PCB MFG |  | 1 | PCB Manufacture
PCBWAY | $7.300 |  |  | $165 for 20 boards | PCB A |  | 1 | PCB Assembly
PCBWAY | $6.150 |  |  | $123 for 20 boards | PCBWAY parts |  | 1 | PCB Parts
PCBWAY | $3.600 |  |  | $72 for lot |  |  |  | PCBWAY SHIPPING
 |  |  |  | 406
 |  |  |  |  |  |  | Other parts for CodeValue to provide and install
Peng Chun Elec | $4.200 |  |  |  | MOTOR | BKA30D-R5 | 1 | Motor- VID28 | variant 64mm; package motor-64mm; part # VID28-05 or BKA30D-R5
HY Elec. Trade | $2.550 |  |  |  | NANO | NANO | 1 | Arduino Nano (Rev3.0) | type Arduino Nano (3.0); part # A000005 (socketed)
JST | $0.240 |  |  | housing | cable conn. | XHP-5 (https://www.digikey.com/product-detail/en/jst-sales-america-inc/XHP-5/455-2268-ND/1125486) | 2 | cable conn housing | CONN HOUSING XPH 5POS 2.54MM WHITE | JST | 455-2268-ND (https://www.digikey.com/product-detail/en/jst-sales-america-inc/XHP-5/455-2268-ND/1125486)
salena wang | $1.500 |  |  |  | CABLE A | n/a | 1 | cable, signal and power | cable assembly, 5-pin using XH contacts, 26 and 28 gauge wire, XHP-5 connector housing, various lengths to 180mm
 |  |  |  |  |  |  | 5 |  | total other parts
1unit | $27.840
20units | $556.800
