allanschwartz/ClockWall/ClockModule Controller/v1.4c/clock module v1.4c BOM.xlsx

Bill of Materials: clock_module_v1.4c.fzz
/Users/allan/Desktop/ClockWall/ClockWall/Clock Module PCB/v1.4/clock_module_v1.4c.fzz
Thursday, October 19 2017, 19:49:40
Assembly List
Label | Part Type | Properties
C1 | Electrolytic Capacitor | capacitance 47µF; voltage 20V; package 100 mil [THT, electrolytic]; part # 25MH547MEFC6.3X5
C2 | Ceramic Capacitor | capacitance 100nF; voltage 6.3V; package 1206 [SMD, multilayer]
C3 | Ceramic Capacitor | capacitance 100nF; voltage 6.3V; package 1206 [SMD, multilayer]
C4 | Ceramic Capacitor | capacitance 100nF; voltage 6.3V; package 1206 [SMD, multilayer]
D1 | Blue (470nm) LED | color Blue (470nm); package 1206 [SMD]
D2 | Blue (470nm) LED | color Blue (470nm); package 1206 [SMD]
D3 | Blue (470nm) LED | color Blue (470nm); package 1206 [SMD]
D4 | Blue (470nm) LED | color Blue (470nm); package 1206 [SMD]
D5 | Blue (470nm) LED | color Blue (470nm); package 1206 [SMD]
D6 | Blue (470nm) LED | color Blue (470nm); package 1206 [SMD]
D7 | Blue (470nm) LED | color Blue (470nm); package 1206 [SMD]
D8 | Blue (470nm) LED | color Blue (470nm); package 1206 [SMD]
D9 | Blue (470nm) LED | color Blue (470nm); package 1206 [SMD]
D10 | Blue (470nm) LED | color Blue (470nm); package 1206 [SMD]
D11 | Blue (470nm) LED | color Blue (470nm); package 1206 [SMD]
D12 | Blue (470nm) LED | color Blue (470nm); package 1206 [SMD]
J1 | Generic molex header - 5 pins | pins 5; form molex; pin spacing 0.1in (2.54mm); hole size 0.7mm,0.508mm; row single; package THT; part # Male Header
J2 | Generic molex header - 5 pins | pins 5; form molex; pin spacing 0.1in (2.54mm); hole size 0.7mm,0.508mm; row single; package THT; part # Female header
LDR1 | Photocell (LDR) | variant variant 1; resistance@ luminance 16 kOhms@ 10 lux; package THT; resistance@ dark 300 kOhms@ 10 seconds; part # GL5528
LDR2 | Photocell (LDR) | variant variant 1; resistance@ luminance 16 kOhms@ 10 lux; package THT; resistance@ dark 300 kOhms@ 10 seconds; part # GL5528
MOTOR | Motor- VID28 | variant 64mm; package motor-64mm; part # VID28-05 or BKA30D-R5
NANO | Arduino Nano (Rev3.0) | type Arduino Nano (3.0); part # A000005 (socketed)
R1 | 330Ω Resistor | tolerance ±1%; package 1206 [SMD]; resistance 330Ω
R2 | 330Ω Resistor | tolerance ±1%; package 1206 [SMD]; resistance 330Ω
R3 | 330Ω Resistor | tolerance ±1%; package 1206 [SMD]; resistance 330Ω
R4 | 330Ω Resistor | tolerance ±1%; package 1206 [SMD]; resistance 330Ω
R5 | 330Ω Resistor | tolerance ±1%; package 1206 [SMD]; resistance 330Ω
R6 | 330Ω Resistor | tolerance ±1%; package 1206 [SMD]; resistance 330Ω
R7 | 330Ω Resistor | tolerance ±1%; package 1206 [SMD]; resistance 330Ω
R8 | 330Ω Resistor | tolerance ±1%; package 1206 [SMD]; resistance 330Ω
R9 | 330Ω Resistor | tolerance ±1%; package 1206 [SMD]; resistance 330Ω
R10 | 330Ω Resistor | tolerance ±1%; package 1206 [SMD]; resistance 330Ω
R11 | 330Ω Resistor | tolerance ±1%; package 1206 [SMD]; resistance 330Ω
R12 | 330Ω Resistor | tolerance ±1%; package 1206 [SMD]; resistance 330Ω
R13 | 10kΩ Resistor | tolerance ±1%; package 1206 [SMD]; resistance 10kΩ
R14 | 10kΩ Resistor | tolerance ±1%; package 1206 [SMD]; resistance 10kΩ
R15 | 10kΩ Resistor | tolerance ±1%; package 1206 [SMD]; resistance 10kΩ
R16 | 20kΩ Resistor | tolerance ±1%; package 1206 [SMD]; resistance 20kΩ
R17 | 40kΩ Resistor | tolerance ±1%; package 1206 [SMD]; resistance 40kΩ
R18 | 80kΩ Resistor | tolerance ±1%; package 1206 [SMD]; resistance 80kΩ
R19 | 10kΩ Resistor | tolerance ±1%; package 1206 [SMD]; resistance 10kΩ
SW1 | DIP Switch 4 Position | variant variant 2; channels 4; package dipswitch-04; part # C&K BD04 or equiv.
U1 | 74HC595 SMD | package SO16 [SMD]; logic family 74xx; part # 74HC595D, NXT SO16
Shopping List
Amount | Part Type | Properties
SMD Parts for PCBWAY to provide and install |  |  | unit price | extended price | price * 16
3 | Ceramic Capacitor | capacitance 100nF; voltage 6.3V; package 1206 [SMD, multilayer] | $0.032 | $0.096 | $1.54
12 | Blue (470nm) LED | color Blue (470nm); package 1206 [SMD] | $0.054 | $0.648 | $10.37
12 | 330Ω Resistor | tolerance ±1%; package 1206 [SMD]; resistance 330Ω | $0.032 | $0.384 | $6.14
4 | 10kΩ Resistor | tolerance ±1%; package 1206 [SMD]; resistance 10kΩ | $0.032 | $0.128 | $2.05
1 | 20kΩ Resistor | tolerance ±1%; package 1206 [SMD]; resistance 20kΩ | $0.032 | $0.032 | $0.51
1 | 40kΩ Resistor | tolerance ±1%; package 1206 [SMD]; resistance 40kΩ | $0.032 | $0.032 | $0.51
1 | 80kΩ Resistor | tolerance ±1%; package 1206 [SMD]; resistance 80kΩ | $0.032 | $0.032 | $0.51
2 | 74HC595 SMD | package SO16 [SMD]; logic family 74xx; part # 74HC595D, NXT SO16 | $0.162 | $0.324 | $5.18
36 |  | total SMD parts |  | $1.676 | $26.82
THT parts for PCBWAY to provide and install
1 | Electrolytic Capacitor | capacitance 47µF; voltage 20V; package 100 mil [THT, electrolytic]; part # 25MH547MEFC6.3X5 | $0.108 | $0.108 | $1.73
2 | Photocell (LDR), GL5528 | variant variant 1; resistance@ luminance 16 kOhms@ 10 lux; package THT; resistance@ dark 300 kOhms@ 10 seconds; part # GL5528 | $0.162 | $0.324 | $5.18
1 | DIP Switch 4 Position | variant variant 2; channels 4; package dipswitch-04; part # C&K BD04 or equiv.
 |  | https://www.aliexpress.com/item/100pcs-Dip-Switches-SPST-4-Position-2-54mm-0-100-pitch-Through-Hole-Slide-Standard-Actuator/32810242656.html
 |  | https://www.aliexpress.com/item/100pcs-4P-4-Position-DIP-Switch-2-54mm-Pitch-2-Row-8-Pin-DIP-Switch/32663921058.html
 |  | total THT parts |  | $0.432 | $6.912
 |  | total PCBWAY parts
THT Parts for customer (myself) to install:
1 | Generic molex header - 5 pins | pins 5; form molex; pin spacing 0.1in (2.54mm); hole size 0.7mm,0.508mm; row single; package THT; part # Male Header
1 | Generic molex header - 5 pins | pins 5; form molex; pin spacing 0.1in (2.54mm); hole size 0.7mm,0.508mm; row single; package THT; part # Female header
1 | Motor- VID28 or BKA30D-R5 | package motor-64mm; variant 64mm; part # VID28-05 or BKA30D-R5
1 | Arduino Nano (Rev3.0) | type Arduino Nano (3.0); part # A000005 (socketed)
