allanschwartz/ClockWall/ClockModule Controller/v1.4d/clock module v1.4c BOM (pcbway).xlsx

Bill of Materials: clock_module_v1.4d.fzz
/Users/allan/Desktop/ClockWall/ClockWall/Clock Module PCB/v1.4d/clock_module_v1.4d.fzz
Sunday, October 22 2017, 20:47:45
Assembly List
Label | Part Type | Properties
C1 | Electrolytic Capacitor | package 100 mil [THT, electrolytic]; capacitance 47µF; voltage 20V; part # 25MH547MEFC6.3X5
C2 | Ceramic Capacitor | package 0805 [SMD, multilayer]; capacitance 100nF; voltage 6.3V
C3 | Ceramic Capacitor | package 0805 [SMD, multilayer]; capacitance 100nF; voltage 6.3V
C4 | Ceramic Capacitor | package 0805 [SMD, multilayer]; capacitance 100nF; voltage 6.3V
D1 | Blue (470nm) LED | package 3 mm [THT]; color Blue Clear 3mm round | EALP03RDIGA1 (https://www.digikey.com/product-detail/en/everlight-electronics-co-ltd/EALP03RDIGA1/EALP03RDIGA1-ND/5142133)
D2 | Blue (470nm) LED | package 3 mm [THT]; color Blue Clear 3mm round | EALP03RDIGA1 (https://www.digikey.com/product-detail/en/everlight-electronics-co-ltd/EALP03RDIGA1/EALP03RDIGA1-ND/5142133)
D3 | Blue (470nm) LED | package 3 mm [THT]; color Blue Clear 3mm round | EALP03RDIGA1
D4 | Blue (470nm) LED | package 3 mm [THT]; color Blue Clear 3mm round | EALP03RDIGA1
D5 | Blue (470nm) LED | package 3 mm [THT]; color Blue Clear 3mm round | EALP03RDIGA1
D6 | Blue (470nm) LED | package 3 mm [THT]; color Blue Clear 3mm round | EALP03RDIGA1
D7 | Blue (470nm) LED | package 3 mm [THT]; color Blue Clear 3mm round | EALP03RDIGA1
D8 | Blue (470nm) LED | package 3 mm [THT]; color Blue Clear 3mm round | EALP03RDIGA1
D9 | Blue (470nm) LED | package 3 mm [THT]; color Blue Clear 3mm round | EALP03RDIGA1
D10 | Blue (470nm) LED | package 3 mm [THT]; color Blue Clear 3mm round | EALP03RDIGA1
D11 | Blue (470nm) LED | package 3 mm [THT]; color Blue Clear 3mm round | EALP03RDIGA1
D12 | Blue (470nm) LED | package 3 mm [THT]; color Blue Clear 3mm round | EALP03RDIGA1
J1 | Generic molex header - 5 pins | package THT; hole size 0.7mm,0.508mm; pins 5; form molex; row single; pin spacing 0.1in (2.54mm); part # Male Header
J2 | Generic molex header - 5 pins | package THT; hole size 0.7mm,0.508mm; pins 5; form molex; row single; pin spacing 0.1in (2.54mm); part # Female header
LDR1 | Photocell (LDR) | resistance@ luminance 16 kOhms@ 10 lux; package THT; resistance@ dark 300 kOhms@ 10 seconds; variant variant 1; part # GL5528
LDR2 | Photocell (LDR) | resistance@ luminance 16 kOhms@ 10 lux; package THT; resistance@ dark 300 kOhms@ 10 seconds; variant variant 1; part # GL5528
MOTOR | Motor- VID28 | package motor-64mm; variant 64mm; part # VID28-05 or BKA30D-R5
NANO | Arduino Nano (Rev3.0) | type Arduino Nano (3.0); part # A000005 (socketed)
R1 | 330Ω Resistor | package 1206 [SMD]; tolerance ±1%; resistance 330Ω
R2 | 330Ω Resistor | package 1206 [SMD]; tolerance ±1%; resistance 330Ω
R3 | 330Ω Resistor | package 1206 [SMD]; tolerance ±1%; resistance 330Ω
R4 | 330Ω Resistor | package 1206 [SMD]; tolerance ±1%; resistance 330Ω
R5 | 330Ω Resistor | package 1206 [SMD]; tolerance ±1%; resistance 330Ω
R6 | 330Ω Resistor | package 1206 [SMD]; tolerance ±1%; resistance 330Ω
R7 | 330Ω Resistor | package 1206 [SMD]; tolerance ±1%; resistance 330Ω
R8 | 330Ω Resistor | package 1206 [SMD]; tolerance ±1%; resistance 330Ω
R9 | 330Ω Resistor | package 1206 [SMD]; tolerance ±1%; resistance 330Ω
R10 | 330Ω Resistor | package 1206 [SMD]; tolerance ±1%; resistance 330Ω
R11 | 330Ω Resistor | package 1206 [SMD]; tolerance ±1%; resistance 330Ω
R12 | 330Ω Resistor | package 1206 [SMD]; tolerance ±1%; resistance 330Ω
R13 | 10kΩ Resistor | package 1206 [SMD]; tolerance ±1%; resistance 10kΩ
R14 | 10kΩ Resistor | package 1206 [SMD]; tolerance ±1%; resistance 10kΩ
R15 | 10kΩ Resistor | package 1206 [SMD]; tolerance ±1%; resistance 10kΩ
R16 | 20kΩ Resistor | package 1206 [SMD]; tolerance ±1%; resistance 20kΩ
R17 | 40kΩ Resistor | package 1206 [SMD]; tolerance ±1%; resistance 40kΩ
R18 | 80kΩ Resistor | package 1206 [SMD]; tolerance ±1%; resistance 80kΩ
R19 | 10kΩ Resistor | package 1206 [SMD]; tolerance ±1%; resistance 10kΩ
SW1 | DIP Switch 4 Position | package dipswitch-04; channels 4; variant variant 2; part # C&K BD04 or equiv.
U1 | 74HC595 SMD | package SO16 [SMD]; logic family 74xx; part # 74HC595D, NXT SO16
U2 | 74HC595 SMD | package SO16 [SMD]; logic family 74xx; part # 74HC595D, NXT SO16
Shopping List
Amount | Part Type | Properties |  |  |  |  |  | seeed
SMD Parts for vendor to provide and install |  |  |  | unit price | extended price | price * 16 | digi-key PN | SKU | MPN | price
3 | Ceramic Capacitor | voltage 6.3V; package 0805 [SMD, multilayer]; capacitance 100nF |  |  |  |  | 399-7999-1-ND (https://www.digikey.com/product-detail/en/kemet/C0805C104K8RACTU/399-7999-1-ND/3471722) | 302010165 | C0805C104K8RACTU (https://www.digikey.com/product-detail/en/kemet/C0805C104K8RACTU/399-7999-1-ND/3471722) | KEMET
12 | 330Ω Resistor | tolerance ±1%; package 1206 [SMD]; resistance 330Ω |  |  |  |  | 311-330FRDKR-ND (https://www.digikey.com/product-detail/en/yageo/RC1206FR-07330RL/311-330FRDKR-ND/734716) |  | RC1206FR-07330RL (https://www.digikey.com/product-detail/en/yageo/RC1206FR-07330RL/311-330FRCT-ND/731769) | YAGEO
4 | 10kΩ Resistor | tolerance ±1%; package 1206 [SMD]; resistance 10kΩ |  |  |  |  | 311-10.0KFRCT-ND (https://www.digikey.com/product-detail/en/yageo/RC1206FR-0710KL/311-10.0KFRCT-ND/731430) |  | RC1206FR-0710KL (https://www.digikey.com/product-detail/en/yageo/RC1206FR-0710KL/311-10.0KFRCT-ND/731430) | YAGEO
1 | 20kΩ Resistor | tolerance ±1%; package 1206 [SMD]; resistance 20kΩ |  |  |  |  | 311-20.0KFRCT-ND (https://www.digikey.com/product-detail/en/yageo/RC1206FR-0720KL/311-20.0KFRCT-ND/731619) |  | RC1206FR-0720KL (https://www.digikey.com/product-detail/en/yageo/RC1206FR-0720KL/311-20.0KFRCT-ND/731619) | YAGEO
1 | 40kΩ Resistor | tolerance ±1%; package 1206 [SMD]; resistance 40kΩ |  |  |  |  | 311-40.2KFRCT-ND (https://www.digikey.com/product-detail/en/yageo/RC1206FR-0740K2L/311-40.2KFRCT-ND/731846) |  | RC1206FR-0740K2L (https://www.digikey.com/product-detail/en/yageo/RC1206FR-0740K2L/311-40.2KFRCT-ND/731846) | YAGEO
1 | 80kΩ Resistor | tolerance ±1%; package 1206 [SMD]; resistance 80kΩ |  |  |  |  | 311-80.6KFRCT-ND (https://www.digikey.com/product-detail/en/yageo/RC1206FR-0780K6L/311-80.6KFRCT-ND/732073) |  | RC1206FR-0780K6L (https://www.digikey.com/product-detail/en/yageo/RC1206FR-0780K6L/311-80.6KFRCT-ND/732073) | YAGEO
2 | 74HC595 SMD | logic family 74xx; package SO16 [SMD]; part # 74HC595D, NXT SO16 |  |  |  |  | 296-8344-5-ND (https://www.digikey.com/product-detail/en/texas-instruments/SN74HC595D/296-8344-5-ND/376752) |  | SN74HC595D (https://www.digikey.com/product-detail/en/texas-instruments/SN74HC595D/296-8344-5-ND/376752) | TI
24 |  | total SMD parts |  |  | $0.000 | $0.00
THT parts for vendor to provide and install
1 | Electrolytic Capacitor | voltage 20V; package 100 mil [THT, electrolytic]; capacitance 47µF; part # 25MH547MEFC6.3X5 |  |  |  |  | 399-6098-ND (https://www.digikey.com/product-detail/en/kemet/ESH476M035AE3AA/399-6098-ND/2712504) | 302030035 | ESH476M035AE3AA (https://www.digikey.com/product-detail/en/kemet/ESH476M035AE3AA/399-6098-ND/2712504) | KEMET
12 | Blue (470nm) LED | package 3 mm [THT]; color Blue Clear 3mm round |  |  |  |  | EALP03RDIGA1-ND (https://www.digikey.com/product-detail/en/everlight-electronics-co-ltd/EALP03RDIGA1/EALP03RDIGA1-ND/5142133) |  | EALP03RDIGA1 (https://www.digikey.com/product-detail/en/everlight-electronics-co-ltd/EALP03RDIGA1/EALP03RDIGA1-ND/5142133) | Everlight
2 | Photocell (LDR) | variant variant 1; resistance@ luminance 16 kOhms@ 10 lux; package THT; resistance@ dark 300 kOhms@ 10 seconds; part # GL5528 |  |  |  |  | DV-P8103-ND (https://www.digikey.com/product-detail/en/luna-optoelectronics/PDV-P8103/PDV-P8103-ND/480610) |  | PDV-P8103 (https://www.digikey.com/product-detail/en/luna-optoelectronics/PDV-P8103/PDV-P8103-ND/480610) | Luna OE
1 | DIP Switch 4 Position | variant variant 2; package dipswitch-04; channels 4; part # C&K BD04 or equiv. |  |  |  |  | CT2064ST-ND (https://www.digikey.com/product-detail/en/cts-electrocomponents/206-4ST/CT2064ST-ND/20774) |  | 206-4ST (https://www.digikey.com/product-detail/en/cts-electrocomponents/206-4ST/CT2064ST-ND/20774) | CTS
2 | generic female headers - 16 pins | 1x16 female headers, e.g,, DigiKey p/n S7049-ND |  |  |  |  | S7049-ND (https://www.digikey.com/product-detail/en/sullins-connector-solutions/PPPC161LFBN-RC/S7049-ND/810188) |  | PPPC161LFBN-RC (https://www.digikey.com/product-detail/en/sullins-connector-solutions/PPPC161LFBN-RC/S7049-ND/810188) | Sullins
 |  | total THT parts |  |  | $0.000 | $0.000
 |  | total parts
THT Parts for customer (myself) to install:
1 | Motor- VID28 | variant 64mm; package motor-64mm; part # VID28-05 or BKA30D-R5
1 | Arduino Nano (Rev3.0) | type Arduino Nano (3.0); part # A000005 (socketed)
1 | Generic male header - 5 pins | pins 5;pin spacing 0.1in (2.54mm); hole size 0.7mm,0.508mm; row single; package THT; part # Male Header
1 | Generic female header - 5 pins | pins 5;pin spacing 0.1in (2.54mm); hole size 0.7mm,0.508mm; row single; package THT; part # Female header
