allanschwartz/ClockWall/ClockModule Controller/v1.4d/revised BOM v1.4d.xlsx

 |  |  |  |  |  |  | Bill of Materials: clock_module_v1.4d.fzz
 |  |  |  |  |  |  | /Users/allan/Desktop/ClockWall/ClockWall/Clock Module PCB/v1.4d/clock_module_v1.4d.fzz
 |  |  |  |  |  |  | Sunday, October 22 2017, 20:47:45
 |  |  |  |  |  |  | Shopping List
digi-key | digi-key | PCBWAY | PCBWAY |  |  | *suggested* | Amount | Part Type | Properties |  | seeed
Unit price | Total | Unit price | Total | Note | LABEL | MPN | SMD Parts for vendor to provide and install |  |  | digi-key PN | SKU | price
$0.095 | $0.285 | $0.054 | $0.162 |  | C2, C3, C4 | C0805C104K8RACTU (https://www.digikey.com/product-detail/en/kemet/C0805C104K8RACTU/399-7999-1-ND/3471722) | 3 | Ceramic Capacitor | voltage 6.3V; package 0805 [SMD, multilayer]; capacitance 100nF | 399-7999-1-ND (https://www.digikey.com/product-detail/en/kemet/C0805C104K8RACTU/399-7999-1-ND/3471722) | 302010165 | KEMET
$0.014 | $0.163 | $0.032 | $0.389 |  | R1,R2,R3,R4,R5,R6 R7,R8,R9,R10,R11,R12 | RC1206FR-07330RL (https://www.digikey.com/product-detail/en/yageo/RC1206FR-07330RL/311-330FRCT-ND/731769) | 12 | 330Ω Resistor | tolerance ±1%; package 1206 [SMD]; resistance 330Ω | 311-330FRDKR-ND (https://www.digikey.com/product-detail/en/yageo/RC1206FR-07330RL/311-330FRDKR-ND/734716) |  | YAGEO
$0.033 | $0.132 | $0.032 | $0.130 |  | R13,R14,R15,R19 | RC1206FR-0710KL (https://www.digikey.com/product-detail/en/yageo/RC1206FR-0710KL/311-10.0KFRCT-ND/731430) | 4 | 10kΩ Resistor | tolerance ±1%; package 1206 [SMD]; resistance 10kΩ | 311-10.0KFRCT-ND (https://www.digikey.com/product-detail/en/yageo/RC1206FR-0710KL/311-10.0KFRCT-ND/731430) |  | YAGEO
$0.033 | $0.033 | $0.032 | $0.032 |  | R16 | RC1206FR-0720KL (https://www.digikey.com/product-detail/en/yageo/RC1206FR-0720KL/311-20.0KFRCT-ND/731619) | 1 | 20kΩ Resistor | tolerance ±1%; package 1206 [SMD]; resistance 20kΩ | 311-20.0KFRCT-ND (https://www.digikey.com/product-detail/en/yageo/RC1206FR-0720KL/311-20.0KFRCT-ND/731619) |  | YAGEO
$0.033 | $0.033 | $0.032 | $0.032 |  | R17 | RC1206FR-0740K2L (https://www.digikey.com/product-detail/en/yageo/RC1206FR-0740K2L/311-40.2KFRCT-ND/731846) | 1 | 39kΩ Resistor | tolerance ±1%; package 1206 [SMD]; resistance 40kΩ | 311-40.2KFRCT-ND (https://www.digikey.com/product-detail/en/yageo/RC1206FR-0740K2L/311-40.2KFRCT-ND/731846) |  | YAGEO
$0.033 | $0.033 | $0.032 | $0.032 |  | R18 | RC1206FR-0780K6L (https://www.digikey.com/product-detail/en/yageo/RC1206FR-0780K6L/311-80.6KFRCT-ND/732073) | 1 | 82kΩ Resistor | tolerance ±1%; package 1206 [SMD]; resistance 80kΩ | 311-80.6KFRCT-ND (https://www.digikey.com/product-detail/en/yageo/RC1206FR-0780K6L/311-80.6KFRCT-ND/732073) |  | YAGEO
$0.540 | $1.080 | $0.216 | $0.432 |  | U1, U2 | SN74HC595D (https://www.digikey.com/product-detail/en/texas-instruments/SN74HC595D/296-8344-5-ND/376752) | 2 | 74HC595D SMD | logic family 74xx; package SO16 [SMD]; part # 74HC595D, NXT SO16 | 296-8344-5-ND (https://www.digikey.com/product-detail/en/texas-instruments/SN74HC595D/296-8344-5-ND/376752) |  | TI
 |  |  |  |  |  |  | 24 |  | total SMD parts
 |  |  |  |  |  |  | THT parts for vendor to provide and install
$0.135 | $0.135 | $0.108 | $0.108 | MADE IN CHINA 47UF 25V 5*7MM | C1 | ESH476M035AE3AA (https://www.digikey.com/product-detail/en/kemet/ESH476M035AE3AA/399-6098-ND/2712504) | 1 | Electrolytic Capacitor | voltage 20V; package 100 mil [THT, electrolytic]; capacitance 47µF; part # 25MH547MEFC6.3X5 | 399-6098-ND (https://www.digikey.com/product-detail/en/kemet/ESH476M035AE3AA/399-6098-ND/2712504) | 302030035 | KEMET
$0.208 | $2.496 | $0.076 | $0.907 |  | D1,D2,D3,D4,D5,D6 D7,D8,D9,D10,D11,D12 | WP710A10QBC/D (https://www.digikey.com/product-detail/en/kingbright/WP710A10QBC-D/754-1596-ND/2769812) | 12 | Blue (470nm) LED | package 3 mm [THT]; color Blue Clear 3mm round | EALP03RDIGA1-ND (https://www.digikey.com/product-detail/en/everlight-electronics-co-ltd/EALP03RDIGA1/EALP03RDIGA1-ND/5142133) |  | Everlight
$0.740 | $1.480 | $0.216 | $0.432 |  | LDR1, LDR2 | PDV-P8103 (https://www.digikey.com/product-detail/en/luna-optoelectronics/PDV-P8103/PDV-P8103-ND/480610) | 2 | Photocell (LDR), GL5528 | variant variant 1; resistance@ luminance 16 kOhms@ 10 lux; package THT; resistance@ dark 300 kOhms@ 10 seconds; part # GL5528 | DV-P8103-ND (https://www.digikey.com/product-detail/en/luna-optoelectronics/PDV-P8103/PDV-P8103-ND/480610) |  | Luna OE
$0.920 | $0.920 | $0.432 | $0.432 |  | SW1 | 206-4ST (https://www.digikey.com/product-detail/en/cts-electrocomponents/206-4ST/CT2064ST-ND/20774) | 1 | DIP Switch 4 Position, red | variant variant 2; package dipswitch-04; channels 4; part # C&K BD04 or equiv. | CT2064ST-ND (https://www.digikey.com/product-detail/en/cts-electrocomponents/206-4ST/CT2064ST-ND/20774) |  | CTS
$0.890 | $1.780 | $0.216 | $0.432 |  | NANO | PPPC161LFBN-RC (https://www.digikey.com/product-detail/en/sullins-connector-solutions/PPPC161LFBN-RC/S7049-ND/810188) | 2 | generic female headers - 16 pins | 1x16 female headers, e.g,, DigiKey p/n S7049-ND | S7049-ND (https://www.digikey.com/product-detail/en/sullins-connector-solutions/PPPC161LFBN-RC/S7049-ND/810188) |  | Sullins
1unit | $8.570 | 1unit | $3.521
10units | $85.702 | 10units | $35.208 |  |  |  |  |  | total THT parts
 |  |  |  |  |  |  |  |  | total parts
 |  |  |  |  |  |  | Other Parts for customer (myself) to install:
 |  |  |  |  |  | Dror to buy | 1 | Motor- VID28 | variant 64mm; package motor-64mm; part # VID28-05 or BKA30D-R5
 |  |  |  |  |  | Dror to buy | 1 | Arduino Nano (Rev3.0) | type Arduino Nano (3.0); part # A000005 (socketed)
 |  |  |  |  |  | have on-hand | 1 | Generic male header - 5 pins | pins 5;pin spacing 0.1in (2.54mm); hole size 0.7mm,0.508mm; row single; package THT; part # Male Header
 |  |  |  |  |  | have on-hand | 1 | Generic female header - 5 pins | pins 5;pin spacing 0.1in (2.54mm); hole size 0.7mm,0.508mm; row single; package THT; part # Female header
 |  |  |  |  |  | buy from boltdepot.com |  | nylon standoffs
 |  |  |  |  |  | bought on ebay |  | DuPont 1*5 shells
 |  |  |  |  |  | to custom build |  | power/signal cable
