allanschwartz/ClockWall/_Hardware/_VID28 Motor/vid28, measurements.xlsx

Allan Schwartz
2017-08-08
clockwall project -- analysis of holes for VID28-05 and neo pixel ring
 |  |  | VID28-05
 |  |  |  |  |  | when mech is
 |  |  |  |  |  | lower-flush, horiz. centered
 |  |  |  |  |  | on a 90w x 83h PCB,
 |  | (x,y) with origin at |  | (x1,y1) with origin at | center: | (x2,y2) with origin | center:
item | hole dia. | mech. Center | (x,y) | mech. upper left corner | (x1,y1) | pcb upper left corner | (x2,y2)
shaft | 5.2mm | (0,0) | (0,0) | (35/2, 64/2 - 9.5) | (17.5, 22.5) | (90/2-17.5 + x1, 19 + y1) | (45, 41.5)
A1 | 1mm |  |  | (35/2 + 22.85/2, 64/2 - 23.24/2 - 7.7) | (28.925, 12.68) | (27.5 + x1, 19 + y1)
A2 | 1mm |  |  | (35/2 + 22.85/2, 64/2 - 23.24/2) | (28.925, 20.38) | (27.5 + x1, 19 + y1)
A3 | 1mm |  |  | (35/2 - 22.85/2, 64/2 - 23.24/2) | (6.075, 20.38) | (27.5 + x1, 19 + y1)
A4 | 1mm |  |  | (35/2 - 22.85/2, 64/2 - 23.24/2 - 7.7) | (6.075, 12.68) | (27.5 + x1, 19 + y1)
B1 | 1mm |  |  | (35/2 - 22.85/2, 64/2 + 23.24/2 +7.7) | (6.075, 51.52) | (27.5 + x1, 19 + y1)
B2 | 1mm |  |  | (35/2 - 22.85/2, 64/2 + 23.24/2) | (6.075, 43.62) | (27.5 + x1, 19 + y1)
B3 | 1mm |  |  | (35/2 + 22.85/2, 64/2 + 23.24/2) | (28.925, 43.62) | (27.5 + x1, 19 + y1)
B4 | 1mm |  |  | (35/2 + 22.85/2, 64/2 + 23.24/2 +7.7) | (28.925, 51.52) | (27.5 + x1, 19 + y1)
align1 | 3mm | (-9, -25) |  | (35/2 - 9, 64/2 - 25) | (8.5, 7) | (27.5 + x1, 19 + y1) | (36, 26)
align2 | 3mm | (+12, 0) |  | (35/2 + 12, 64/2) | (29.5, 32) | (27.5 + x1, 19 + y1) | (57, 41)
align3 | 3mm | (-9, +25) |  | (35/2 - 9, 64/2 + 25) | (8.5, 57) | (27.5 + x1, 19 + y1) | (36, 76)
NEO Pixel ring, 12-element
Outer diameter: 36.8mm / 1.45"
Inner diameter: 23.3mm / 0.92"
Thickness: 3.25mm / 0.13"
RLED | 15
RPIN | 17.25
placement of 4 contacts:
 |  | theta in | (x,y) with origin at |  | center: | (x2,y2) with origin | center:
item | theta | radians | mech. Center | y | (x1,y1) | pcb upper left corner | (x2,y2)
LED3 | 0 | 0 | 15 | 0 |  | 32.5
LED2 | 30 | 0.5235987756 | 12.99038106 | 7.5
LED1 | 60 | 1.047197551 | 7.5 | 12.99038106
LED0 | 90 | 1.570796327 | 9.188613412e-16 | 15
IN | 105 | 1.832595715 | -4.464628528 | 16.6622205
LED11 | 120 | 2.094395102 | -7.5 | 12.99038106
LED10 | 150 | 2.617993878 | -12.99038106 | 7.5
OUT | 165 | 2.879793266 | -16.6622205 | 4.464628528
LED9 | 180 | 3.141592654 | -15 | 1.837722682e-15
LED8 | 210 | 3.665191429 | -12.99038106 | -7.5
LED7 | 240 | 4.188790205 | -7.5 | -12.99038106
LED6 | 270 | 4.71238898 | -2.756584024e-15 | -15
PWR | 285 | 4.974188368 | 4.464628528 | -16.6622205
LED5 | 300 | 5.235987756 | 7.5 | -12.99038106
LED4 | 330 | 5.759586532 | 12.99038106 | -7.5
GND | 345 | 6.021385919 | 16.6622205 | -4.464628528
there is no mechanical spec, that I could find. I suppose it is somewhere in the Eagle file here:
https://github.com/adafruit/Adafruit-NeoPixel-Ring/blob/master/Adafruit%20NeoPixel%20Ring%2012.brd
Install my own LEDS
Radius to center of LED |  | 21
 |  | theta in | (x,y) with origin at |  | center: | (x2,y2) with origin | center:
item | theta | radians | mech. Center | y | (x1,y1) | pcb upper left corner | (x2,y2)
D3 | 0 | 0 | 21 | 0
D4 | 30 | 0.5235987756 | 18.18653348 | 10.5
D5 | 60 | 1.047197551 | 10.5 | 18.18653348
D6 | 90 | 1.570796327 | 1.286405878e-15 | 21
D7 | 120 | 2.094395102 | -10.5 | 18.18653348
D8 | 150 | 2.617993878 | -18.18653348 | 10.5
D9 | 180 | 3.141592654 | -21 | 2.572811755e-15
D10 | 210 | 3.665191429 | -18.18653348 | -10.5
D11 | 240 | 4.188790205 | -10.5 | -18.18653348
D12 | 270 | 4.71238898 | -3.859217633e-15 | -21
D1 | 300 | 5.235987756 | 10.5 | -18.18653348
D2 | 330 | 5.759586532 | 18.18653348 | -10.5
