allanschwartz/ClockWall/Cluster Controller/Power Signal Dist v1.1/Power Signal Dist_bom.html

Label | Part Type | Properties
C1 | Electrolytic Capacitor | voltage 35V; capacitance 1µF; package 100 mil [THT, electrolytic]
C2 | Ceramic Capacitor | voltage 6.3V; capacitance 100nF; package 1206 [SMD, multilayer]
C3 | Electrolytic Capacitor | voltage 35V; capacitance 1µF; package 100 mil [THT, electrolytic]
C4 | Ceramic Capacitor | voltage 6.3V; capacitance 100nF; package 1206 [SMD, multilayer]
C5 | Electrolytic Capacitor | voltage 35V; capacitance 1µF; package 100 mil [THT, electrolytic]
C6 | Ceramic Capacitor | voltage 6.3V; capacitance 100nF; package 1206 [SMD, multilayer]
C7 | Electrolytic Capacitor | voltage 35V; capacitance 1µF; package 100 mil [THT, electrolytic]
C8 | Ceramic Capacitor | voltage 6.3V; capacitance 100nF; package 1206 [SMD, multilayer]
C9 | Ceramic Capacitor | voltage 6.3V; capacitance 1µF; package 1206 [SMD, multilayer]
J-A | Generic female header - 5 pins | pin spacing 0.1in (2.54mm); hole size 1.0mm,0.508mm; pins 5; form ♀ (female); package THT; row single
J-B | Generic female header - 5 pins | pin spacing 0.1in (2.54mm); hole size 1.0mm,0.508mm; pins 5; form ♀ (female); package THT; row single
J-C | Generic female header - 5 pins | pin spacing 0.1in (2.54mm); hole size 1.0mm,0.508mm; pins 5; form ♀ (female); package THT; row single
J-D | Generic female header - 5 pins | pin spacing 0.1in (2.54mm); hole size 1.0mm,0.508mm; pins 5; form ♀ (female); package THT; row single
J1 | Generic female header - 5 pins | pin spacing 0.1in (2.54mm); hole size 1.0mm,0.508mm; pins 5; form ♀ (female); package THT; row single
J2/PWR | Generic molex header - 3 pins | pin spacing 0.1in (2.54mm); hole size 1.0mm,0.508mm; pins 3; form molex; package THT; row single
J3/TP | Generic male header - 3 pins | pin spacing 0.1in (2.54mm); hole size 1.0mm,0.508mm; pins 3; form ♂ (male); package THT; row single
LED1 | Green (565nm) LED | color Green (565nm); package 1206 [SMD]
LED2 | Green (565nm) LED | color Green (565nm); package 1206 [SMD]
LED3 | Green (565nm) LED | color Green (565nm); package 1206 [SMD]
LED4 | Green (565nm) LED | color Green (565nm); package 1206 [SMD]
LED5 | Yellow (585nm) LED | color Yellow (585nm); package 1206 [SMD]
Part1 | Schematic Frame | sheet 1/1; project ClockWall; rev 1.0; date 1515840094; filename Power Signal Dist.fzz; descr CLockWall Power & Signal Distribution PCB
R1 | 1kΩ Resistor | resistance 1kΩ; package 1206 [SMD]; tolerance ±1%
R2 | 1kΩ Resistor | resistance 1kΩ; package 1206 [SMD]; tolerance ±1%
R3 | 1kΩ Resistor | resistance 1kΩ; package 1206 [SMD]; tolerance ±1%
R4 | 1kΩ Resistor | resistance 1kΩ; package 1206 [SMD]; tolerance ±1%
R5 | 220Ω Resistor | resistance 220Ω; package 1206 [SMD]; tolerance ±1%
U1 | Voltage Regulator - 5V | voltage 5V; package TO220 [THT]; part # LM7805
U2 | Voltage Regulator - 5V | voltage 5V; package TO220 [THT]; part # LM7805
U3 | Voltage Regulator - 5V | voltage 5V; package TO220 [THT]; part # LM7805
U4 | Voltage Regulator - 5V | voltage 5V; package TO220 [THT]; part # LM7805
Amount | Part Type | Properties
4 | Electrolytic Capacitor | voltage 35V; capacitance 1µF; package 100 mil [THT, electrolytic]
4 | Ceramic Capacitor | voltage 6.3V; capacitance 100nF; package 1206 [SMD, multilayer]
1 | Ceramic Capacitor | voltage 6.3V; capacitance 1µF; package 1206 [SMD, multilayer]
5 | Generic female header - 5 pins | pin spacing 0.1in (2.54mm); hole size 1.0mm,0.508mm; pins 5; form ♀ (female); package THT; row single
1 | Generic molex header - 3 pins | pin spacing 0.1in (2.54mm); hole size 1.0mm,0.508mm; pins 3; form molex; package THT; row single
1 | Generic male header - 3 pins | pin spacing 0.1in (2.54mm); hole size 1.0mm,0.508mm; pins 3; form ♂ (male); package THT; row single
4 | Green (565nm) LED | color Green (565nm); package 1206 [SMD]
1 | Yellow (585nm) LED | color Yellow (585nm); package 1206 [SMD]
1 | Schematic Frame | sheet 1/1; project ClockWall; rev 1.0; date 1515840094; filename Power Signal Dist.fzz; descr CLockWall Power & Signal Distribution PCB
4 | 1kΩ Resistor | resistance 1kΩ; package 1206 [SMD]; tolerance ±1%
1 | 220Ω Resistor | resistance 220Ω; package 1206 [SMD]; tolerance ±1%
4 | Voltage Regulator - 5V | voltage 5V; package TO220 [THT]; part # LM7805
