allanschwartz/ClockWall/ClockModule Controller/v1.3/clock_module_smd_v1.3_bom.html

Label | Part Type | Properties
C1 | Ceramic Capacitor | package 0805 [SMD, multilayer]; capacitance 4.7µF; voltage 6.3V
C2 | Ceramic Capacitor | package 0805 [SMD, multilayer]; capacitance 100nF; voltage 6.3V
CONN1 | Generic male header - 5 pins | pins 5; form ♂ (male); package THT; hole size 1.0mm,0.508mm; row single; pin spacing 0.1in (2.54mm)
CONN2 | Generic male header - 5 pins | pins 5; form ♂ (male); package THT; hole size 1.0mm,0.508mm; row single; pin spacing 0.1in (2.54mm)
D1 | Blue (505nm) LED | package 0805 [SMD]; color Blue (505nm)
D2 | Blue (505nm) LED | package 0805 [SMD]; color Blue (505nm)
D3 | Blue (505nm) LED | package 0805 [SMD]; color Blue (505nm)
D4 | Blue (505nm) LED | package 0805 [SMD]; color Blue (505nm)
D5 | Blue (505nm) LED | package 0805 [SMD]; color Blue (505nm)
D6 | Blue (505nm) LED | package 0805 [SMD]; color Blue (505nm)
D7 | Blue (505nm) LED | package 0805 [SMD]; color Blue (505nm)
D8 | Blue (505nm) LED | package 0805 [SMD]; color Blue (505nm)
D9 | Blue (505nm) LED | package 0805 [SMD]; color Blue (505nm)
D10 | Blue (505nm) LED | package 0805 [SMD]; color Blue (505nm)
D11 | Blue (505nm) LED | package 0805 [SMD]; color Blue (505nm)
D12 | Blue (505nm) LED | package 0805 [SMD]; color Blue (505nm)
LDR1 | Photocell (LDR) | package THT; resistance@ luminance 16 kOhms@ 10 lux; variant variant 1; resistance@ dark 300 kOhms@ 10 seconds; part # GL5528
LDR2 | Photocell (LDR) | package THT; resistance@ luminance 16 kOhms@ 10 lux; variant variant 1; resistance@ dark 300 kOhms@ 10 seconds; part # GL5528
NANO | Arduino Nano (Rev3.0) | type Arduino Nano (3.0); part # Nano, socketed
Part1 | Schematic Frame | sheet 1/1; project ClockWall project; filename clock_module_smd_v1.3.fzz; date 1505802182; rev 1.2
R1 | 330Ω Resistor | package 0805 [SMD]; tolerance ±5%; resistance 330Ω
R2 | 330Ω Resistor | package 0805 [SMD]; tolerance ±5%; resistance 330Ω
R3 | 330Ω Resistor | package 0805 [SMD]; tolerance ±5%; resistance 330Ω
R4 | 330Ω Resistor | package 0805 [SMD]; tolerance ±5%; resistance 330Ω
R5 | 330Ω Resistor | package 0805 [SMD]; tolerance ±5%; resistance 330Ω
R6 | 330Ω Resistor | package 0805 [SMD]; tolerance ±5%; resistance 330Ω
R7 | 330Ω Resistor | package 0805 [SMD]; tolerance ±5%; resistance 330Ω
R8 | 330Ω Resistor | package 0805 [SMD]; tolerance ±5%; resistance 330Ω
R9 | 330Ω Resistor | package 0805 [SMD]; tolerance ±5%; resistance 330Ω
R10 | 330Ω Resistor | package 0805 [SMD]; tolerance ±5%; resistance 330Ω
R11 | 330Ω Resistor | package 0805 [SMD]; tolerance ±5%; resistance 330Ω
R12 | 330Ω Resistor | package 0805 [SMD]; tolerance ±5%; resistance 330Ω
R13 | 2.2kΩ Resistor | package 0805 [SMD]; tolerance ±1%; resistance 2.2kΩ
R14 | 2.2kΩ Resistor | package 0805 [SMD]; tolerance ±1%; resistance 2.2kΩ
R15 | 2.2kΩ Resistor | package 0805 [SMD]; tolerance ±1%; resistance 2.2kΩ
R16 | 2.2kΩ Resistor | package 0805 [SMD]; tolerance ±1%; resistance 2.2kΩ
R18 | 10kΩ Resistor | package 0805 [SMD]; tolerance ±5%; resistance 10kΩ
R19 | 10kΩ Resistor | package 0805 [SMD]; tolerance ±5%; resistance 10kΩ
R20 | 2.2kΩ Resistor | package 0805 [SMD]; tolerance ±1%; resistance 2.2kΩ
R21 | 1kΩ Resistor | package 0805 [SMD]; tolerance ±1%; resistance 1kΩ
R22 | 1kΩ Resistor | package 0805 [SMD]; tolerance ±1%; resistance 1kΩ
R23 | 1kΩ Resistor | package 0805 [SMD]; tolerance ±1%; resistance 1kΩ
SW1 | DIP Switch 4 Position | package dipswitch-04; channels 4; variant variant 2
U1 | 74HC595 SMD | package SO16 [SMD]; logic family 74xx; part # 74HC595 D
U2 | 74HC595 SMD | package SO16 [SMD]; logic family 74xx; part # 74HC595 D
VID28-05 | Motor- VID28 | package motor-64mm; variant 64mm; part # VID28-05 or equiv.
Amount | Part Type | Properties
1 | Ceramic Capacitor | package 0805 [SMD, multilayer]; capacitance 4.7µF; voltage 6.3V
1 | Ceramic Capacitor | package 0805 [SMD, multilayer]; capacitance 100nF; voltage 6.3V
2 | Generic male header - 5 pins | pins 5; form ♂ (male); package THT; hole size 1.0mm,0.508mm; row single; pin spacing 0.1in (2.54mm)
12 | Blue (505nm) LED | package 0805 [SMD]; color Blue (505nm)
2 | Photocell (LDR) | package THT; resistance@ luminance 16 kOhms@ 10 lux; variant variant 1; resistance@ dark 300 kOhms@ 10 seconds; part # GL5528
1 | Arduino Nano (Rev3.0) | type Arduino Nano (3.0); part # Nano, socketed
1 | Schematic Frame | sheet 1/1; project ClockWall project; filename clock_module_smd_v1.3.fzz; date 1505802182; rev 1.2
12 | 330Ω Resistor | package 0805 [SMD]; tolerance ±5%; resistance 330Ω
5 | 2.2kΩ Resistor | package 0805 [SMD]; tolerance ±1%; resistance 2.2kΩ
2 | 10kΩ Resistor | package 0805 [SMD]; tolerance ±5%; resistance 10kΩ
3 | 1kΩ Resistor | package 0805 [SMD]; tolerance ±1%; resistance 1kΩ
1 | DIP Switch 4 Position | package dipswitch-04; channels 4; variant variant 2
2 | 74HC595 SMD | package SO16 [SMD]; logic family 74xx; part # 74HC595 D
1 | Motor- VID28 | package motor-64mm; variant 64mm; part # VID28-05 or equiv.
