allanschwartz/ClockWall/ClockModule Controller/v1.5/ClockWall Module assembly, 2018-01-01.pdf

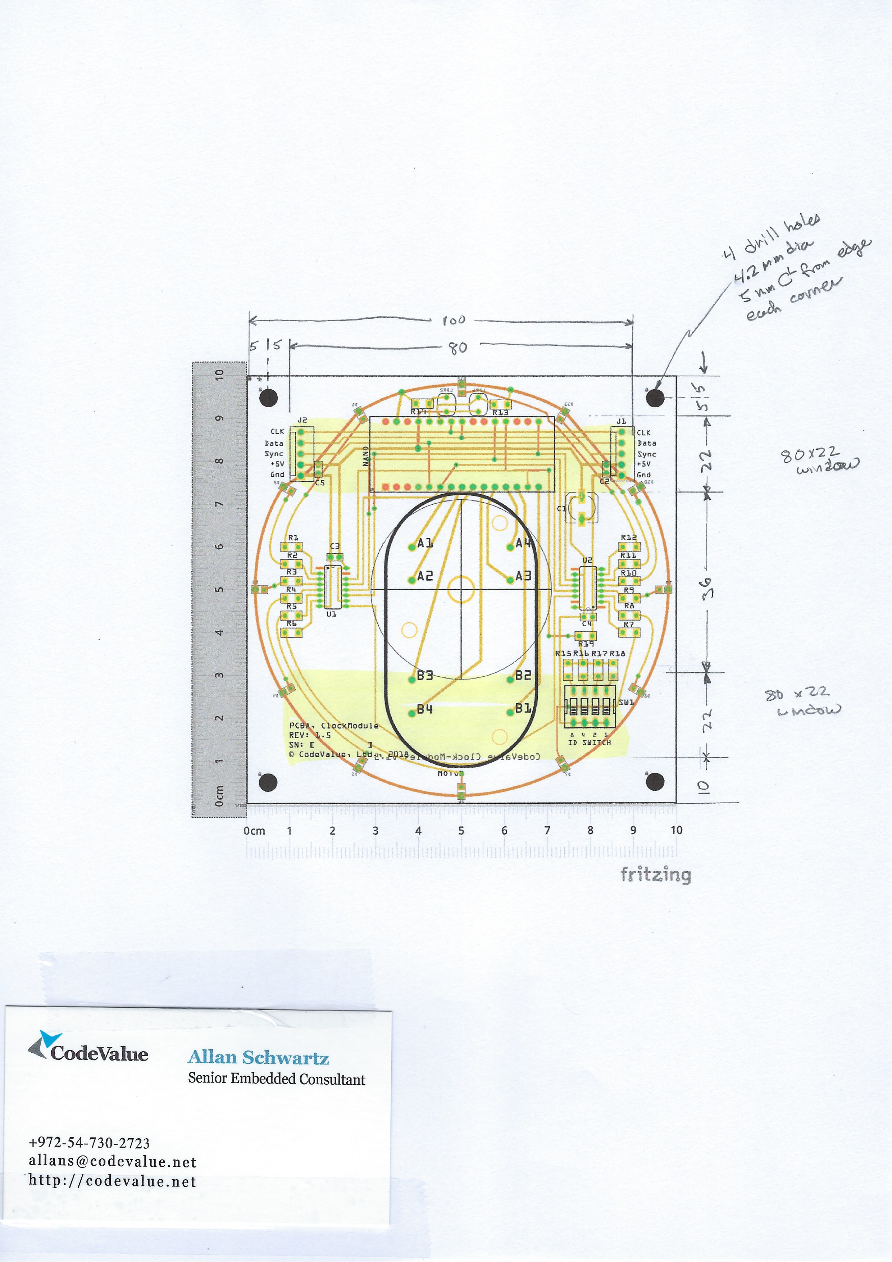
[picture p64: page 1]
