allanschwartz/ClockWall/_Hardware/abandoned 4_clock_module/4_clock_module_bb.pdf

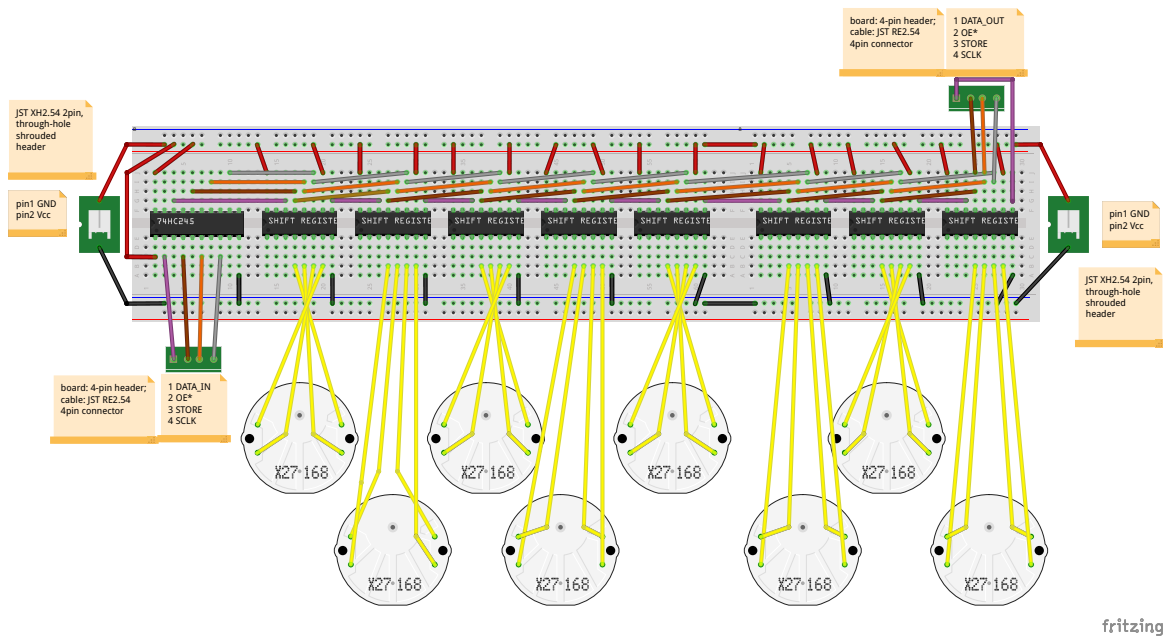
[picture p65: page 1]
pin; ble: J; ble; ole; ATA_
