allanschwartz/ClockWall/_Hardware/cables/jst_2to5-pin_set_20iv10.pdf

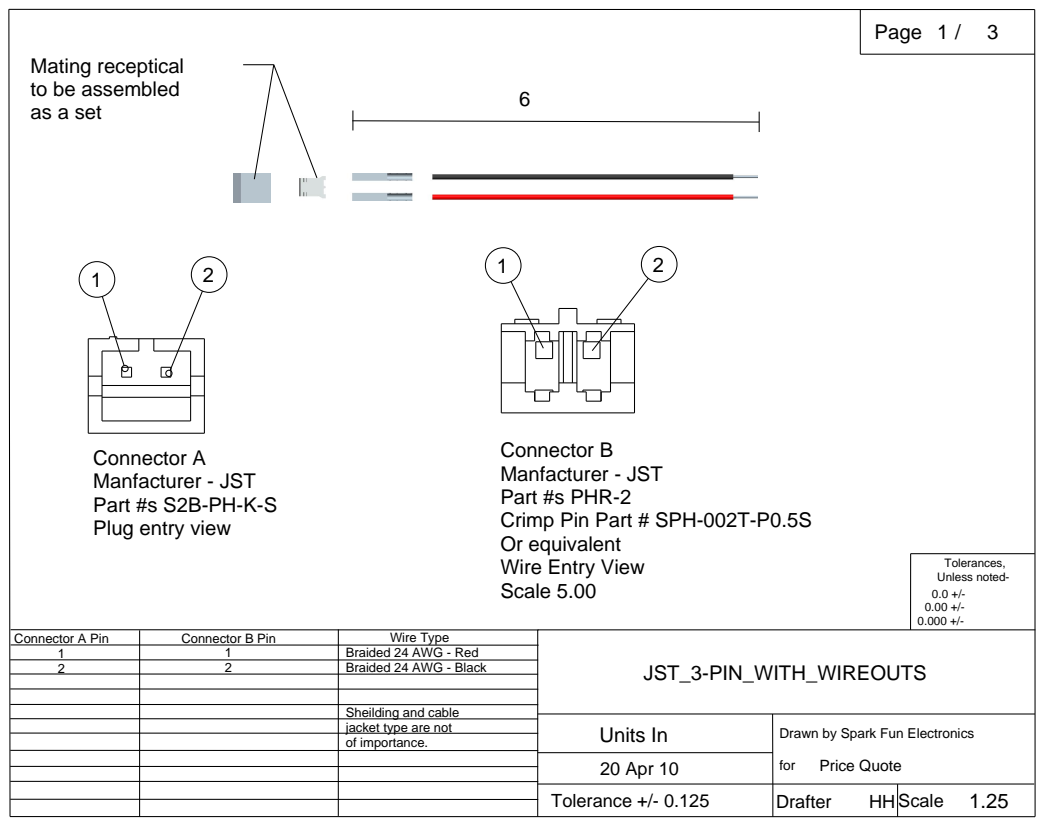
[picture p66: page 1]
Scale; Tolerances, Unless noted- 0.0 +/- 0.00 +/- 0.000 +/-; Units In; 20 Apr 10; Price Quote; Tolerance +/- 0.125

Mating receptical
to be assembled
as a set

Connector B
Manfacturer - JST
Part #s PHR-2
Crimp Pin Part # SPH-002T-P0.5S
Or equivalent
Wire Entry View
Scale 5.00

Connector A
Part #s S2B-PH-K-S
Plug entry view

Connector A Pin | Connector B Pin | Wire Type | JST_3-PIN_WITH_WIREOUTS
1 | 1 | Braided 24 AWG - Red
2 | 2 | Braided 24 AWG - Black

Sheilding and cable
jacket type are not
of importance.

Drawn by Spark Fun Electronics
for
Drafter

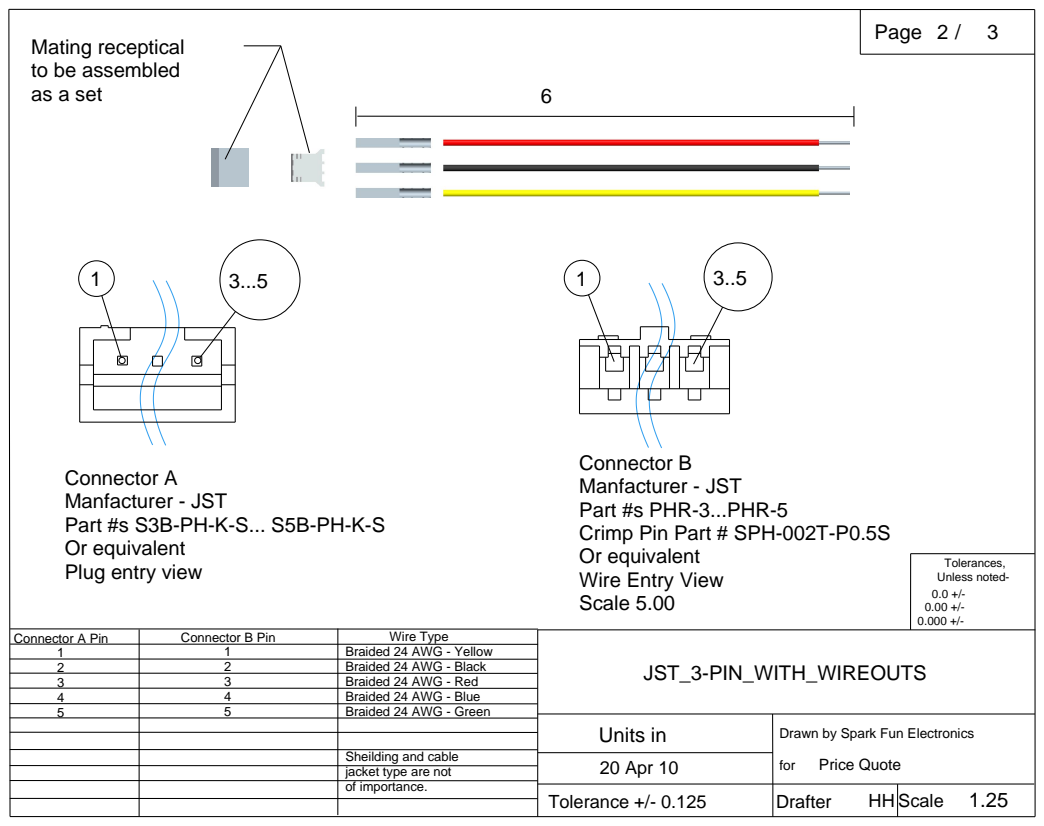
[picture p67: page 2]
Tolerances, Unless noted- 0.0 +/- 0.00 +/- 0.000 +/-; Units in; 20 Apr 10; Price Quote

Mating receptical
to be assembled
as a set

Connector B
Manfacturer - JST
Part #s PHR-3...PHR-5
Crimp Pin Part # SPH-002T-P0.5S
Or equivalent
Wire Entry View
Scale 5.00

Connector A
Part #s S3B-PH-K-S... S5B-PH-K-S
Plug entry view

Connector A Pin | Connector B Pin | Wire Type | JST_3-PIN_WITH_WIREOUTS
1 | 1 | Braided 24 AWG - Yellow
2 | 2 | Braided 24 AWG - Black
3 | 3 | Braided 24 AWG - Red
4 | 4 | Braided 24 AWG - Blue
5 | 5 | Braided 24 AWG - Green

Drawn by Spark Fun Electronics
for

Sheilding and cable
jacket type are not
of importance. | Tolerance +/- 0.125 | HH | 1.25

Drawn by Spark Fun Electronics for

JST_3-PIN_WITH_WIREOUTS

Tolerances,
Unless noted-0.0 +/-
0.00 +/-
0.000 +/-

Set number Part Numbers (Parts from JST or equivalent)
Notes
1 2 | 1 x S2B-PH-K-S 1 x PHR-2 2 x SPH-002T-P0.5S 2 x Braided 24 AWG 1 x S3B-PH-K-S 1 x PHR-3 3 x SPH-002T-P0.5S 3 x Braided 24 AWG | Wire colors and order given on sheet 1 Wire colors and order given on sheet 2 (use yellow, black, & red wires)
3 | 1 x S4B-PH-K-S 1 x PHR-4 4 x SPH-002T-P0.5S 4 x Braided 24 AWG | Wire colors and order given on sheet 2 (use yellow, black, red, and blue wires)
| | Wire colors and order given on sheet 2 (use yellow, black, red, blue, and green wires)
4

1 x S5B-PH-K-S
1 x PHR-5
5 x SPH-002T-P0.5S
5 x Braided 24 AWG
