allanschwartz/ClockWall/_Hardware/abandoned 4_clock_module/4_clock_module_pcb.pdf

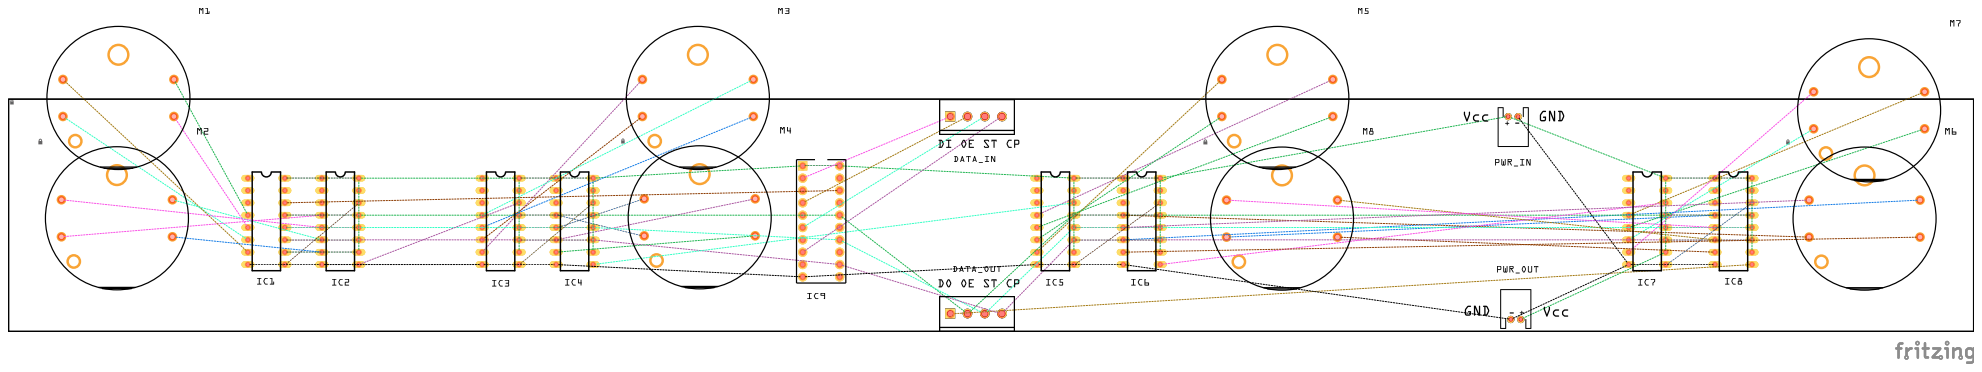
[picture p68: page 1]
