allanschwartz/ClockWall/_Hardware/abandoned 4_clock_module/4_clock_module_schem.pdf

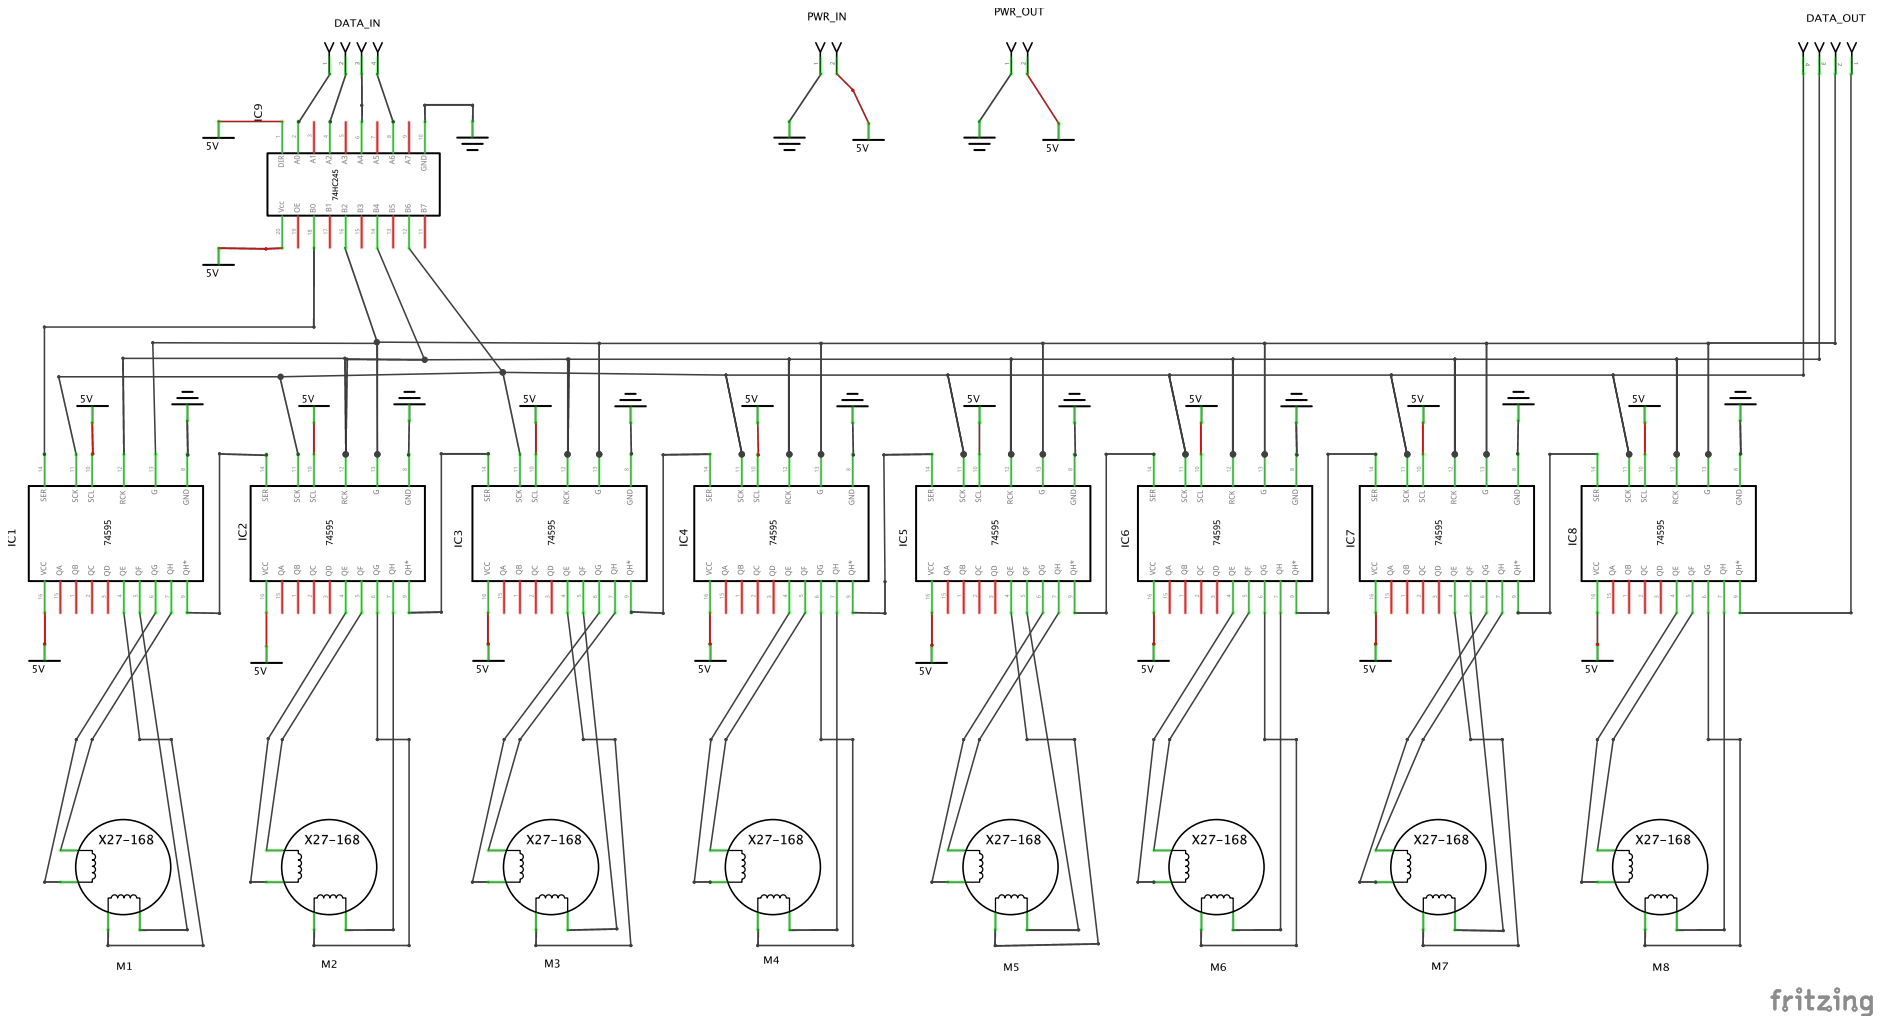
[picture p69: page 1]
