allanschwartz/ClockWall/(list of files, drawings)

Other design files:
_Hardware/_VID28 Motor/test.fzz
_Hardware/abandoned 1_clock_module/clockwall element.fzz
_Hardware/abandoned 4_clock_module/4_clock_module.fzz
_Hardware/cables/clock module cable, 2.54mm.fzz
ClockModule Controller/V1.0/clock_module_v1.0.fzz
ClockModule Controller/V1.1/clock_module_v1.1.fzz
ClockModule Controller/V1.2/clock_module_smd_v1.2.fzz
ClockModule Controller/v1.3/clock_module_smd_v1.3.fzz
ClockModule Controller/v1.4c/clock_module_v1.4c.fzz
ClockModule Controller/v1.4d/clock_module_v1.4d no LEDs.fzz
ClockModule Controller/v1.4d/clock_module_v1.4d.fzz
ClockModule Controller/v1.5/clock_module_v1.5 noLEDs.fzz
ClockModule Controller/v1.5/clock_module_v1.5.fzz
Cluster Controller/cluster controller v1.0.fzz
Cluster Controller/cluster_controller_v1.1.fzz
Cluster Controller/Power Signal Dist v1.1/Power Signal Dist 1.1.fzz
Cluster Controller/Power Signal Dist v1.2/Power Signal Dist 1.2.fzz
