allanschwartz/ClockWall/(commit log)

2017-09-07 big initial checkin
    init checkin
    [4_clock_module.fzz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]
2017-09-07 small changes
    [clock_module_v1.0.fzz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]
2017-12-19 snapshot, end of milestone 2
    [Quotation W07135ASD15-10sets-clock module v1.4c BOM (pcbway) 2017-10-23.xlsx, Quotation W07135ASD15-10sets-clock module v1.4c BOM (pcbway) 2017-10-24.xlsx, Quotation W07135ASD15-10sets-clock module v1.4c BOM 2017-10-23.xlsx, clock module BOM v1.5.xlsx, clock module cable, 2.0mm.fzz, clock module cable, 2.54mm.fzz, clock module v1.4c BOM (pcbway).xlsx, clock module v1.4c BOM (seed).xlsx]
2018-01-24 work in progress, toward milestone 3
    [Power Signal Dist 1.1.fzz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]
2018-07-02 some renames
    [Quotation W07135ASD15-10sets-clock module v1.4c BOM (pcbway) 2017-10-23.xlsx, Quotation W07135ASD15-10sets-clock module v1.4c BOM (pcbway) 2017-10-24.xlsx, Quotation W07135ASD15-10sets-clock module v1.4c BOM 2017-10-23.xlsx, clock module BOM v1.5.xlsx, clock module cable, 2.54mm.fzz, clock module v1.4c BOM (pcbway).xlsx, clock module v1.4c BOM (seed).xlsx, clock module v1.4c BOM.xlsx]
